CIJE-STEM/cije-weather-station/data/anemometer_data-V_vs_RPM.jpg

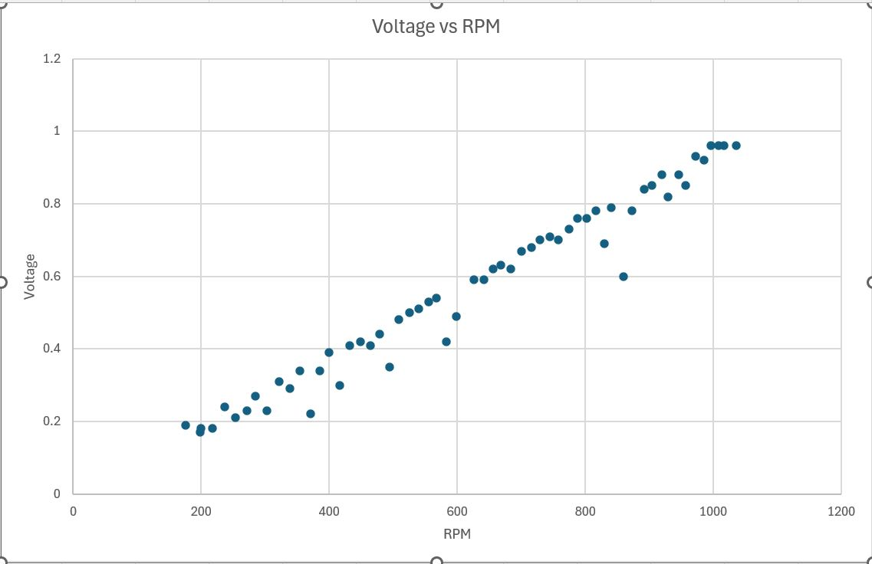
data/anemometer_data-V_vs_RPM.jpg
