CIJE-STEM/cije-weather-station/docs/ESP32-layout.png

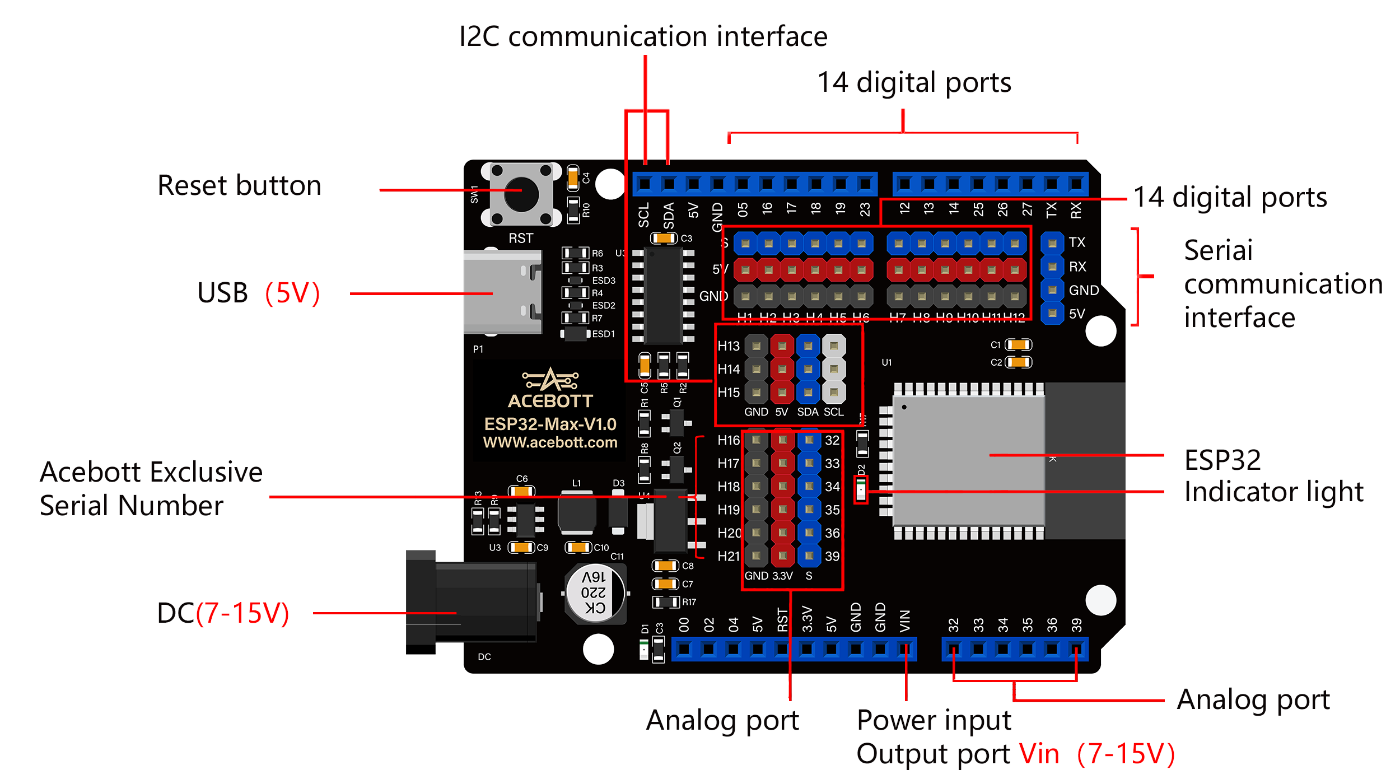
docs/ESP32-layout.png
