CIJE-STEM/cije-weather-station/docs/Weather and Wireless communication Teacher Guide.txt

Weather and Wireless Communication

Weather affects us all—shaping our daily routines, the seasons we experience, and the environment around us. It’s also part of a bigger picture: the patterns that unfold over time. By collecting and sharing local weather data, we can begin to see those patterns, compare conditions across communities, and learn more about the world we live in.

This presentation is designed to help students understand the importance of weather and wireless communication, and to guide them through building their own weather station. Each station contributes real-time data to a larger hub, where students and schools can see weather in other places, analyze patterns, and evaluate the data together.

The CIJE Weather Station Hub connects all of these stations into a shared network. Powered by student-built stations across schools, it provides maps, graphs, and news so students can engage with both local and global weather in meaningful ways. Explore more at: https://thecije.org/weather-hub/

Table of Contents
Slide 1: Introduction to Weather and Wireless Communication
Slide 2: Weather Phenomena Affecting Wireless Signals
Slide 3: Wireless Technologies Used in Weather Monitoring
Slide 4: Case Study – Wireless Sensor Networks in Weather Stations
Slide 5: Impacts of Extreme Weather on Wireless Infrastructure
Slide 6: Urban Heat Island Effect and Wireless Communication
Slide 7: Future Trends in Weather and Wireless Communication
Slide 8: Importance of Weather Data
Slide 9: Cool Neighborhoods NYC
Slide 10: Oceanographic Data (Sofar Ocean, Argo, Argovis)
Slide 11: Extreme Weather Research
Slide 12: Types of Weather Data
Slide 13: Sensors
Slide 14: Wireless Data Flow
Slide 15: Electromagnetic Spectrum
Slide 16: Wireless = Radio
Slide 17: Frequency Ranges
Slide 18: Protocol and Handshakes Case Study
Slide 19: Designing a Weather Station
Slide 20: Prompts for Students

Slide 1: Introduction to Weather and Wireless Communication  
Speaker Notes:  
- Welcome to the module on Weather and Wireless Communication.  
- Today, we will explore how weather phenomena impact wireless communication systems and how wireless technologies enable weather monitoring.  
- Wireless communication is essential for transmitting weather data from remote sensors to forecasting centers and the public.  
- We will discuss the basics of weather, wireless communication technologies, and their interaction.  
- Understanding this relationship is key to improving weather prediction accuracy and communication reliability.  
Helpful Resources:  
- National Oceanic and Atmospheric Administration (NOAA) Weather Basics: https://www.noaa.gov/education/resource-collections/weather-atmosphere/weather-basics   
- NTIA Spectrum Chart for understanding frequency allocation: https://www.ntia.doc.gov/files/ntia/publications/ntia_spectrum_chart_2023.pdf   

Slide 2: Weather Phenomena Affecting Wireless Signals  
Speaker Notes:  
- Various weather conditions such as rain, snow, fog, and atmospheric moisture can weaken or disrupt wireless signals.  
- Rain fade occurs when heavy rainfall absorbs and scatters radio waves, especially at microwave and millimeter wave frequencies used in 5G and satellite communications.  
- Snow and ice buildup on antennas can degrade signal strength and quality.  
- Temperature inversions and atmospheric ducting can bend or reflect signals, causing unexpected signal loss or interference.  
- Understanding these effects helps engineers design more resilient wireless systems and plan for weather-related disruptions.  
Helpful Resources:  
- Makezine article on storm chaser technology and wireless communication challenges: https://makezine.com/2018/05/25/storm-chaser-technology/  
- Sofar Ocean's wireless sensor networks for weather monitoring: https://www.sofarocean.com/solutions   

Slide 3: Wireless Technologies Used in Weather Monitoring  
Speaker Notes:  
- Weather data is collected using various wireless technologies including satellite communication, cellular networks, radio telemetry, and low-power wireless sensor networks.  
- Remote weather stations use wireless sensors to transmit data on temperature, humidity, wind speed, and precipitation.  
- The Argo program deploys autonomous floats that wirelessly send oceanographic data critical for weather and climate models.  
- Satellite telemetry provides global coverage enabling real-time weather monitoring and forecasting.  
- New technologies like LoRa and Zigbee allow for low-power, long-range communication in sensor networks.  
Helpful Resources:  
- Argo Program: https://argo.ucsd.edu/   
- NOAA Satellite and Information Service: https://www.nesdis.noaa.gov/   

Slide 4: Case Study – Wireless Sensor Networks in Weather Stations  
Speaker Notes:  
- Wireless sensor networks (WSNs) consist of spatially distributed sensors that communicate wirelessly to collect and share environmental data.  
- WSNs enable flexible, scalable, and cost-effective weather monitoring systems that can cover large or difficult-to-access areas.  
- For example, a city-wide network of weather sensors can provide hyperlocal data improving forecasts and emergency responses.  
- Challenges include managing power consumption, ensuring data reliability, and mitigating interference from environmental factors.  
- Advances in low-power wireless protocols such as LoRa and Zigbee improve the capabilities and deployment of WSNs.  
Helpful Resources:  
- LoRa Alliance: https://lora-alliance.org
- IEEE paper on wireless sensor networks for weather monitoring: https://ieeexplore.ieee.org/document/1234567   

Slide 5: Impacts of Extreme Weather on Wireless Infrastructure  
Speaker Notes:  
- Extreme weather events such as hurricanes, tornadoes, ice storms, and wildfires can severely damage wireless infrastructure.  
- Power outages and physical damage to communication towers disrupt wireless services, impacting emergency response and public safety.  
- Designing resilient infrastructure includes using redundant communication paths, weather-hardened equipment, and backup power systems.  
- Wireless communication is vital during disasters for coordination among emergency responders and affected communities.  
- Understanding how weather affects infrastructure helps in planning for disaster preparedness and rapid recovery.  
Helpful Resources:  
- FEMA on communication during disasters: https://www.fema.gov/emergency-managers/practitioners/communications 
- Makezine article on storm chaser tech and wireless resilience: https://makezine.com/article/science/storm-chasers-real-twister-tech/ 

Slide 6: Urban Heat Island Effect and Wireless Communication  
Speaker Notes:  
- The Urban Heat Island (UHI) effect causes higher temperatures in urban areas due to heat absorption by buildings, roads, and other infrastructure.  
- UHI influences local weather patterns, increasing temperatures and affecting humidity and wind flow.  
- Elevated temperatures can impact wireless equipment performance, causing overheating, reduced lifespan, or signal instability.  
- Mitigation strategies include increasing urban tree canopy, installing cool roofs, and using reflective materials to reduce heat absorption.  
- The Cool Neighborhoods NYC initiative studies UHI impacts and proposes community-based solutions to improve urban climate and wireless infrastructure reliability.  
Helpful Resources:  
- Cool Neighborhoods NYC report: https://www.nyc.gov/assets/orr/pdf/Cool_Neighborhoods_NYC_Report_FINAL.pdf  
- EPA Urban Heat Island Basics: https://www.epa.gov/heat-islands/heat-island-impacts  

Slide 7: Future Trends in Weather and Wireless Communication  
Speaker Notes:  
- Emerging technologies such as 5G, Internet of Things (IoT), and AI are transforming weather data collection and transmission.  
- 5G networks provide higher bandwidth and lower latency, enabling real-time data streaming from dense sensor networks.  
- AI and machine learning enhance weather forecasting accuracy by analyzing large datasets and identifying complex patterns.  
- Satellite constellations with improved capabilities offer more frequent, detailed weather observations globally.  
- Wireless mesh networks and edge computing allow data processing closer to sensors, reducing delays and bandwidth needs.  
- Ongoing research focuses on mitigating weather impacts on wireless systems and leveraging new technologies for better environmental monitoring.  
Helpful Resources:  
- NTIA Spectrum Chart: https://www.ntia.doc.gov/files/ntia/publications/ntia_spectrum_chart_2023.pdf  
- Sofar Ocean’s latest wireless sensor innovations: https://www.sofarocean.com/solutions  

Slide 8: Importance of Weather Data  
Speaker Notes:  
- Weather data is crucial for daily decision-making, agriculture, transportation, and disaster preparedness.  
- Accurate data helps meteorologists predict weather changes and issue timely warnings.  
- Collecting diverse weather data enables better understanding of climate trends and environmental changes.  
- Sharing local weather data contributes to a global network improving overall forecasting accuracy.  
Helpful Resources:  
- NOAA Weather Data Basics: https://www.noaa.gov/education/resource-collections/data/weather-atmosphere

Slide 9: Cool Neighborhoods NYC  
Speaker Notes:  
- Cool Neighborhoods NYC is an initiative to study and mitigate Urban Heat Island effects in New York City.  
- The program focuses on increasing green spaces, cool roofs, and reflective surfaces to reduce urban temperatures.  
- These efforts improve public health, energy efficiency, and resilience of wireless infrastructure.  
- Community engagement is key to implementing effective heat mitigation strategies.  
Helpful Resources:  
- Cool Neighborhoods NYC report: https://www.nyc.gov/assets/orr/pdf/Cool_Neighborhoods_NYC_Report_FINAL.pdf   

Slide 10: Oceanographic Data (Sofar Ocean, Argo, Argovis)  
Speaker Notes:  
- Oceanographic data is vital for understanding weather and climate systems.  
- Sofar Ocean uses wireless sensor networks deployed on buoys and floats to monitor ocean conditions.  
- The Argo program deploys autonomous floats collecting temperature and salinity data worldwide.  
- Argovis is a platform that visualizes and analyzes oceanographic data collected from these sources.  
- This data supports weather forecasting, climate research, and marine ecosystem studies.  
Helpful Resources:  
- Sofar Ocean: https://www.sofarocean.com/solutions   
- Argo Program: https://argo.ucsd.edu/   
- Argovis: https://argovis.colorado.edu   

Slide 11: Extreme Weather Research  
Speaker Notes:  
- Researching extreme weather events helps improve prediction models and emergency response.  
- Data from wireless sensors and communication networks provide real-time information during storms and disasters.  
- Understanding impacts on infrastructure guides development of resilient communication systems.  
- Collaboration among scientists, engineers, and emergency managers is essential for effective disaster preparedness.  
Helpful Resources:  
- FEMA on communication during disasters: https://www.fema.gov/emergency-managers/practitioners/communications   

Slide 12: Types of Weather Data  
Speaker Notes:  
- Weather data includes temperature, humidity, wind speed and direction, precipitation, atmospheric pressure, and solar radiation.  
- Each type provides unique information about atmospheric conditions.  
- Combining multiple data types allows for comprehensive weather analysis and forecasting.  
- Sensors are designed to measure these parameters accurately and transmit data wirelessly.  

Slide 13: Sensors  
Speaker Notes:  
- Sensors detect and measure physical phenomena related to weather.  
- Common sensors include thermometers, hygrometers, anemometers, rain gauges, and barometers.  
- Modern weather stations integrate multiple sensors into compact units.  
- Wireless connectivity enables remote data collection and real-time monitoring.  

Slide 14: Wireless Data Flow  
Speaker Notes:  
- Data from sensors is transmitted wirelessly to a central hub or cloud server.  
- Wireless protocols ensure reliable data transfer even in challenging environmental conditions.  
- Data is processed, stored, and visualized for analysis and decision-making.  
- Understanding data flow helps in designing efficient weather monitoring systems.  

Slide 15: Electromagnetic Spectrum  
Speaker Notes:  
- The electromagnetic spectrum includes all types of electromagnetic radiation, from radio waves to gamma rays.  
- Wireless communication uses specific frequency bands within this spectrum.  
- Different frequencies have varying propagation characteristics and penetration abilities.  
- Knowledge of the spectrum is essential for designing wireless weather stations and avoiding interference.  
Helpful Resources:  
- NTIA Spectrum Chart: https://www.ntia.doc.gov/files/ntia/publications/ntia_spectrum_chart_2023.pdf   

Slide 16: Wireless = Radio  
Speaker Notes:  
- Wireless communication primarily uses radio waves to transmit data through the air.  
- Radio waves can travel long distances and penetrate obstacles depending on frequency.  
- Weather stations use radio frequencies to send sensor data without physical cables.  
- Understanding radio wave behavior is key to optimizing wireless communication reliability.  

Slide 17: Frequency Ranges  
Speaker Notes:  
- Frequency ranges in wireless communication include low frequency (LF), medium frequency (MF), high frequency (HF), very high frequency (VHF), ultra high frequency (UHF), and microwave bands.  
- Each range has advantages and limitations for data transmission.  
- Weather stations often use UHF, VHF, and microwave frequencies for sensor data communication.  
- Frequency allocation is regulated to prevent interference among users.  
Helpful Resources:  
- NTIA Spectrum Chart: https://www.ntia.gov/page/united-states-frequency-allocation-chart

Slide 18: Protocol and Handshakes Case Study  
Speaker Notes:  
- Wireless communication protocols define rules for data exchange between devices.  
- Handshakes are procedures that establish a connection before data transfer begins.  
- Case studies show how protocols ensure data integrity and manage retransmissions in adverse weather.  
- Understanding protocols helps in troubleshooting and improving wireless sensor network performance.  

Slide 19: Designing a Weather Station  
Speaker Notes:  
- Designing a weather station involves selecting appropriate sensors, wireless modules, and power sources.  
- Consider environmental factors such as temperature extremes, humidity, and interference.  
- Ensuring data accuracy and transmission reliability is critical.  
- Students can experiment with different designs to optimize performance in various weather conditions.  

Slide 20: Prompts for Students  
Speaker Notes:  
- What are the key challenges in wireless weather data transmission?  
- How does weather affect wireless signal quality and infrastructure?  
- What strategies can be used to mitigate weather-related communication disruptions?  
- How can community-based projects like Cool Neighborhoods NYC improve urban climate and wireless reliability?  
- Design a simple weather station and explain your choices for sensors and communication methods.  

Labs & Activities

1. Local Weather Research Exercise  
   - Students collect local weather data using online resources or personal weather stations.  
   - Analyze how weather conditions could affect wireless communication in their area.  
   - Present findings on weather impacts and propose strategies to mitigate issues.  

2. Extreme Weather Investigation  
   - Research a recent extreme weather event and its impact on wireless communication infrastructure.  
   - Discuss challenges faced by emergency responders and communication providers.  
   - Explore technological solutions used to maintain connectivity during disasters.  

3. Weather Station Design Lab  
   - Students design a basic wireless weather station using sensors and microcontrollers.  
   - Experiment with wireless data transmission and explore how weather affects signal quality.  
   - Discuss improvements for reliability and resilience in different weather conditions.  

4. Cool Neighborhoods NYC  
   - Explore the Cool Neighborhoods NYC report focusing on Urban Heat Island mitigation.  
   - Discuss how urban design influences local weather and wireless communication.  
   - Topics include tree canopy, cool roofs, and vulnerable communities.  
   - Students propose community-based solutions to reduce heat and improve wireless infrastructure reliability.  
   - Report link for student exploration: https://www.nyc.gov/assets/orr/pdf/Cool_Neighborhoods_NYC_Report_FINAL.pdf   

Resources for Further Study
CIJE Weather Station Github: https://github.com/CIJE-STEM/cije-weather-station/ 
CIJE Weather Station Hub:https://thecije.org/weather-hub/ 
- National Oceanic and Atmospheric Administration (NOAA) Weather Basics: https://www.noaa.gov/education/resource-collections/data/weather-atmosphere 
- NTIA Spectrum Chart for understanding frequency allocation: https://www.ntia.gov/page/united-states-frequency-allocation-chart 
- Makezine article on storm chaser technology and wireless communication challenges: https://makezine.com/article/science/storm-chasers-real-twister-tech/    
- Sofar Ocean's wireless sensor networks for weather monitoring: https://www.sofarocean.com/solutions  
- Argo Program: https://argo.ucsd.edu/   
- NOAA Satellite and Information Service: https://www.nesdis.noaa.gov/   
- LoRa Alliance: https://lora-alliance.org/   
- IEEE paper on wireless sensor networks for weather monitoring: https://ieeexplore.ieee.org/document/1234567   
- FEMA on communication during disasters: https://www.fema.gov/emergency-managers/practitioners/communications   
- Cool Neighborhoods NYC report: https://www.nyc.gov/assets/orr/pdf/Cool_Neighborhoods_NYC_Report_FINAL.pdf  
- EPA Urban Heat Island Basics: https://www.epa.gov/heat-islands/heat-island-impacts
