CIJE-STEM/cije-weather-station/docs/Weather Station Build BME280 Basic.pdf

Weather Station Build

This Weather Station is just an example of many possible builds using different materials. Depending on what sensors you choose to incorporate, this build is designed to collect up to 4 types of weather data: temperature, humidity, wind speed and (optionally) barometric pressure. Essentially, there are 4 major components that can be adapted to your design preference: Container (+fasteners), sensors, processor, and transmitter.

Components:

Container:
Purchased or Repurposed

Any container that is big enough to hold the components AND is waterproof (sun and rain). Take home food and soup containers.

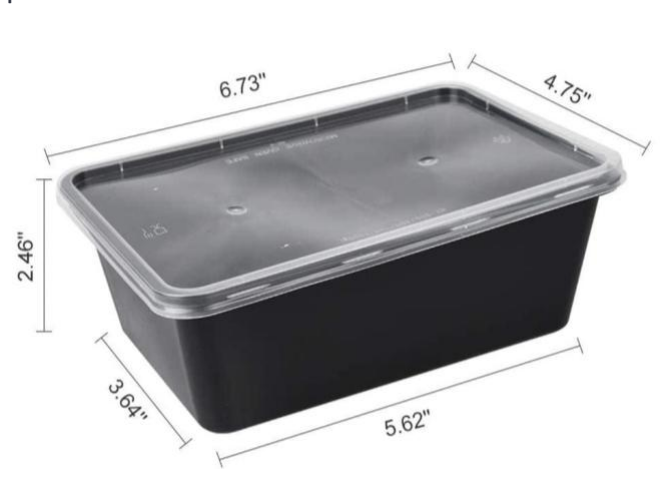
[picture p16: figure]

https://www.amazon.com/Containers-Disposable-Insulated-Microwaveable-Dishwasher/dp/B07BLTDD1V

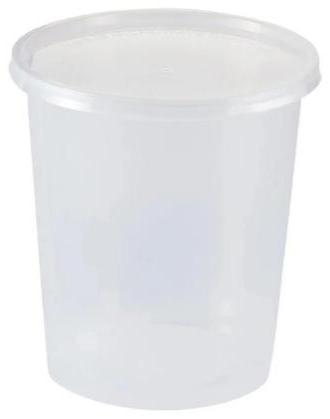
[picture p17: figure]
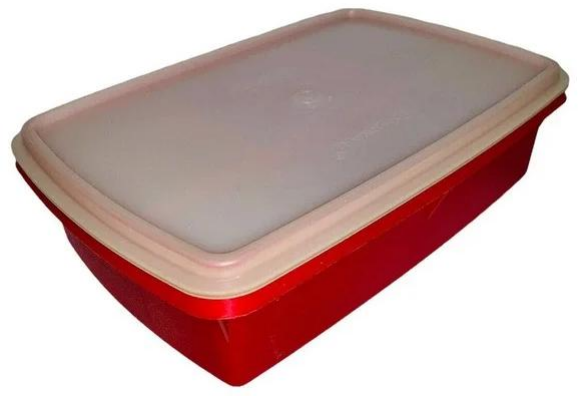
[picture p18: figure]

3D Printed Components.

You can design your own (or use our example seen below).

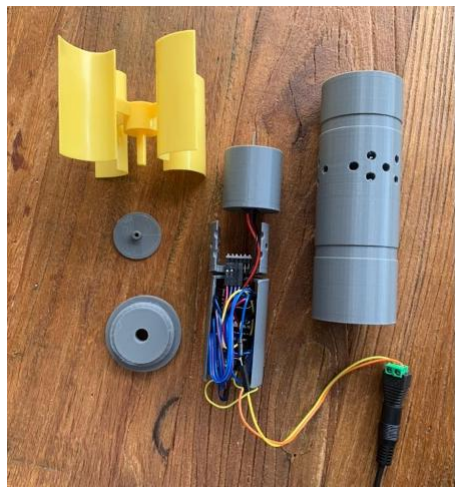
[picture p19: figure]

https://github.com/CIJE-STEM/CIJE-

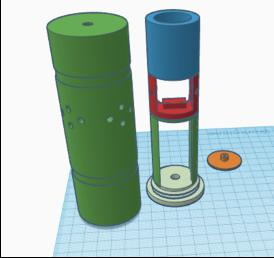
[picture p20: figure]

WeatherHub/tree/main/3D_files/CIJE_Weather_Station1 (https://github.com/CIJE-STEM/CIJE-WeatherHub/tree/main/3D_files/CIJE_Weather_Station1)

That can be adapted via Tinkercad.

https://www.tinkercad.com/things/kYxrZfITcn0-cije-weather-station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 (https://www.tinkercad.com/things/kYxrZfITcn0-cije-weather-station)

Fasteners:

The container needs to be anchored/attached to sometime stable to withstand wind and rain. Zip ties are the easiest to use.

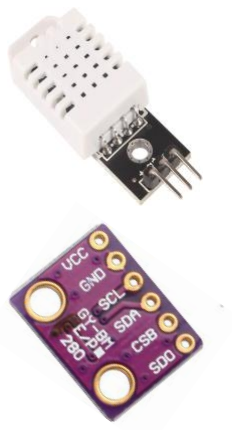
[picture p21: figure]

Sensors:

Temperature/Humidity sensor
- DHT22/DHT11 - I2C device measure temperature and humidity
- BME280 - I2C device measures temperature, humidity, and barometric pressure.

Wind Speed:

Anemometer - We are suggesting an anemometer adapted from a DC motor wind turbine. The voltage output will need to be calibrated to the wind speed.

https://www.amazon.com/Turbine-Vertical-Turbines-Electricity-Generator/dp/B0BWWVQZTG/ref=sr_1_16 (https://www.amazon.com/Turbine-Vertical-Turbines-Electricity-Generator/dp/B0BWWVQZTG/ref=sr_1_16)

Time: (optional)

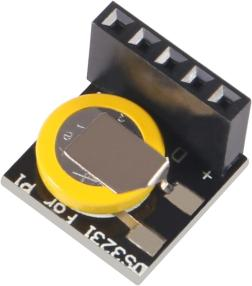
[picture p22: figure]

The DS3231 A real time clock (RTC) is great to have to

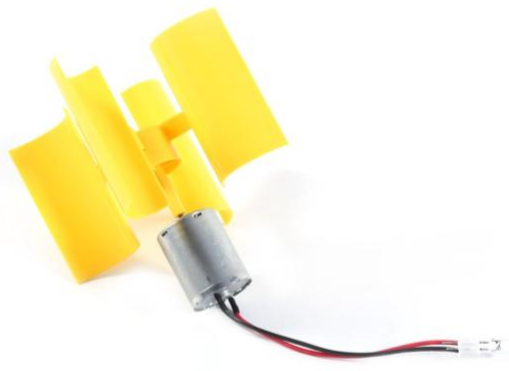
[picture p23: figure]

put the microprocessor to sleep and not use up the power (unless you manage to wire the power) when not in use / when not transmitting the data. There are other versions that are also available. This model has a rechargeable battery vs. a coin cell battery that will eventually need to be replaced.

https://www.amazon.com/Dorhea-DS3231-Module-Memory-

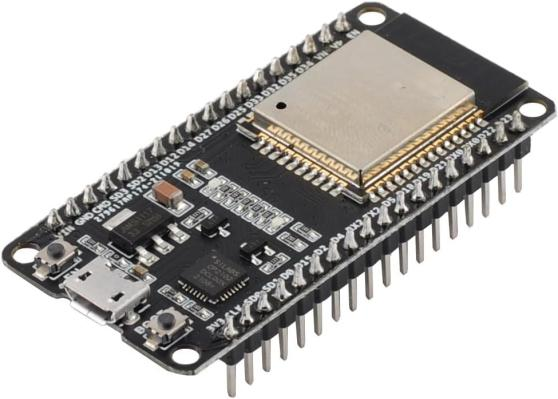
[picture p24: figure]
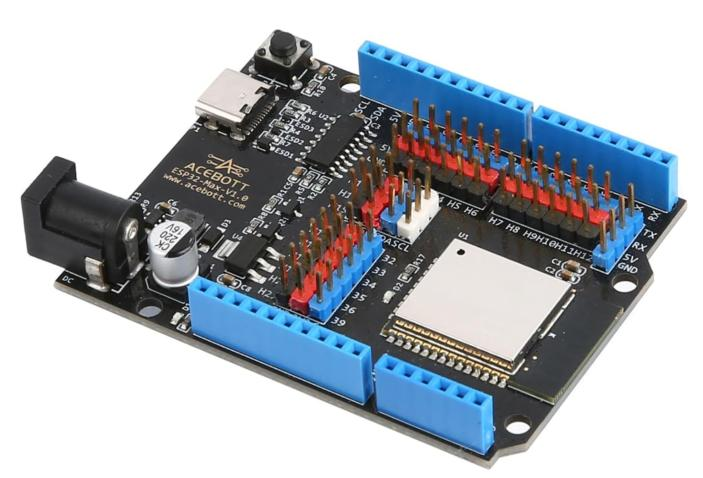
[picture p25: figure]

Raspberry/dp/B08X4H3NBR/ref=sr_1_3? (https://www.amazon.com/Dorhea-DS3231-Module-Memory-Raspberry/dp/B08X4H3NBR/ref=sr_1_3)

Processor/Transmitter

ESP32 (Processor AND transmitter}

Build-Up Options:

Your weather station can be built with a wide variety of options which will be explored. These options may be individual or combined depending on your needs.

Here are possible configurations:

Basic:
Internal sensors require minimal fabrication.
- Temperature, Humidity
- DHT-11, DHT22 Sensors.
- AHT10 Sensor.
- Temperature, Humidity, Pressure.
- BME280.
- Temperature, Humidity, Pressure, VOC’s (Volatile Organic Compounds - Air Quality)
- BME680.

Intermediate:
Sensors requiring some physical material fabrication, holes, mounting materials.
- (Basic Components - as listed above).
- Anemometer - DC Generator, resistors and a mounting bracket, hole for wiring.
- UV Sensor
- Adafruit LTR-390 - requires a hole and weather protective window.

Advanced:
Sensors that require moderate to extensive mechanical fabrication and adaptation, external holes.
- Wind Direction Sensor - rotary magnetic, optical, or mechanical switch sensing with an air vane to detect air flow direction.
- AS5600 - rotary magnetic position sensor.
- A3144 Hall Effect sensor or A3144 Hall Effect sensor module board, magnet(s).
- TCRT5000 Reflectance sensor(s), position disk.
- Participation Sensor (Rain Gauge)
- A3144 Hall Sensor, 3D printed tipping bucket assembly.
- LM393 Rain Drop Sensor Monitor.
- Capacitive Analog Soil Sensor Module.
- Rain gauge sensor with ultrasonic or TOF (Time of Flight) distance sensor.

The above options may be selected or combined to create your weather station. We will explore some of these options with design examples to help you get started.

First Steps:

- What is the intended application of your weather station?
- Classroom project, school project?
- Do you have an intended time frame for installation and use?
- Can you get permission and a designated place to install the weather station?
- Consider the location of your weather station.
- Is it to be inside or outside - Are measuring indoor air quality, lighting, etc.
- Does the location have readily available power?
- Does the location have readily available Wi-Fi?
- Is the location easily accessible?
- Is the location secure?
- What kind of data do you wish to collect?
- Some sensors are easy to use and require very little maintenance others may require occasional repair or adjustment.
- Are you considering microclimate measurement with multiple stations or having a relocatable station?
- How will you share the data with your students, school, community?
- Do you expect that your station and data will be used to help plan or make decisions based on the data you collect? For example, a community garden, air quality monitoring?
Based on the questions above hopefully you can formulate the intent and purpose of the weather station as well as what kind of data you wish to acquire/use.

Project Planning:

Consider the scope of your project and the resources that you will be able to apply. This project can be incremental, and scaled based on the resources that you have at hand. Consider a part of this project could be to build a case for expansion and permanence at your school, location. It may be useful to start small, demonstrate utility or interest and then expand.

Design Example - Basic - Web Based Reporting

In this example we want a weather station that can be located outside but next to a classroom window. We may find a better location later but for now we would like to have something that we can experiment with and easily observe. Power will be routed through the window using a 12V DC power adapter. Wi-Fi is available and reliable next to the window, and we have permission from our IT department to use the network. Our school is happy and interested in having the data posted on the CIJE Weather Station Hub site, so our IT department will allow outgoing internet traffic from our weather station.

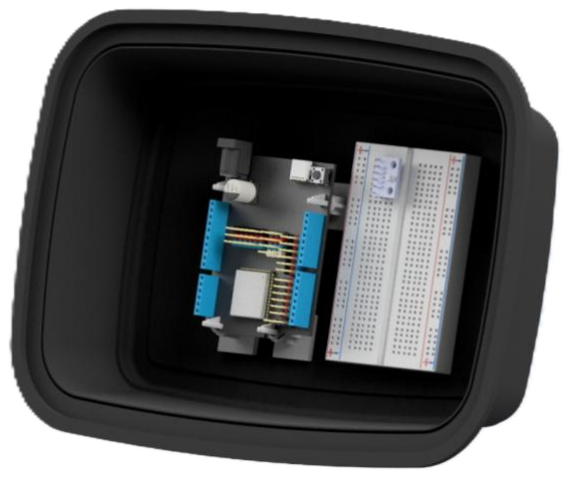
[picture p26: figure]

Shown above is an image of a basic weather station using an ESP32 (ACEBOTT), (https://www.amazon.com/ACEBOTT-Development-Board-Compatible-Arduino/dp/B0D5D7Q42V) a half bread board and a BME280 sensor. This is a very simple example of a web posting weather station.

We have some wiring to do, coding (most of it is provided) and some testing.

Weather Station Specifications:

# | Sensing Parameter | Sensor | Notes

1 | Temperature | BME280 - I2C - 3.3V-5V | Amazon - BM (https://www.amazon.com/SazkJere-GY-BME280-5-Atmospheric-Pressure-Temperature/dp/B0CMHGBPC7)E (https://www.amazon.com/SazkJere-GY-BME280-5-Atmospheric-Pressure-Temperature/dp/B0CMHGBPC7)280 not BM (https://www.amazon.com/SazkJere-GY-BME280-5-Atmospheric-Pressure-Temperature/dp/B0CMHGBPC7)P (https://www.amazon.com/SazkJere-GY-BME280-5-Atmospheric-Pressure-Temperature/dp/B0CMHGBPC7)280 (https://www.amazon.com/SazkJere-GY-BME280-5-Atmospheric-Pressure-Temperature/dp/B0CMHGBPC7)
| Humidity | BME280 - I2C - 3.3V-5V
| Pressure | BME280 - I2C - 3.3V-5V
# | Hardware | Type

2 | ESP32 | ESP32 Board | ACEBOTT UNO format ESP32 (https://www.amazon.com/ACEBOTT-Development-Board-Compatible-Arduino/dp/B0D5D7Q42V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)
3 | Breadboard | Mini Breadboard | Makes for easy design changes (https://www.amazon.com/Breadborad-Solderless-Breadboards-Distribution-Connecting/dp/B082VYXDF1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)
4 | 1N5817 Diode (2) | Overvoltage Protection | 1N5817 Schottky Diode (https://www.amazon.com/dp/B07Q5H1SLY?ref_=ppx_hzsearch_conn_dt_b_fed_asin_title_1)
5 | 10KΩ 1/4W Resistor | Anemometer V/Divider | 10K resistor

6 | 1KΩ 1/4W Resistor | Anemometer V/Divider | 1K resistor (https://www.amazon.com/10K-Resistor-Tolerance-Resistors-Resistance/dp/B0B4JFPHTW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)
7 | 100KΩ 1/4W Resistor | Battery V/Divider | 100K resistor (https://www.amazon.com/10K-Resistor-Tolerance-Resistors-Resistance/dp/B0B4JDHXC9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)
8 | 15KΩ 1/4W Resistor | Battery V/Divider | 15K resistor (https://www.amazon.com/10K-Resistor-Tolerance-Resistors-Resistance/dp/B0B4JCGX1Z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)
9 | 12VDC Adapter | 12V 1A 5.5mm x 2.1mm | Power for Station (https://www.amazon.com/Adapter-Speakers-Appliances-Surveillance-Switching/dp/B0CQXK1FSM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)
10 | Plastic Container | 48 oz, 7” x 10” x 2” | Station Enclosure (https://www.amazon.com/dp/B0CPP3KDQQ?ref_=ppx_hzsearch_conn_dt_b_fed_asin_title_1&th=1) - Zip-tied to block
11 | Snap-in Support | PCB Mounting Post | Amazon PCB Support (https://www.amazon.com/dp/B09WZWY9L3?aref=OMxKOacSRU)
12 | Dupont Jumpers | Female to Male (10) | Component interconnects (https://www.amazon.com/EDGELEC-Breadboard-Optional-Assorted-Multicolored/dp/B07GD2BWPY)
13 | Hot Glue | | To secure items if required

Network

SSID | URSchool
Password | 123456
IT Contact | Phone Number | email
Jim Dandy | 555-2134 | jd@ITOffice.biz

Note:
Resources listed are suggested components and vendors, you may use whatever source you see fit. It is recommended that component substitutes be selected based on similar specifications. Please consult your CIJE High School Mentor if in doubt prior to purchasing.

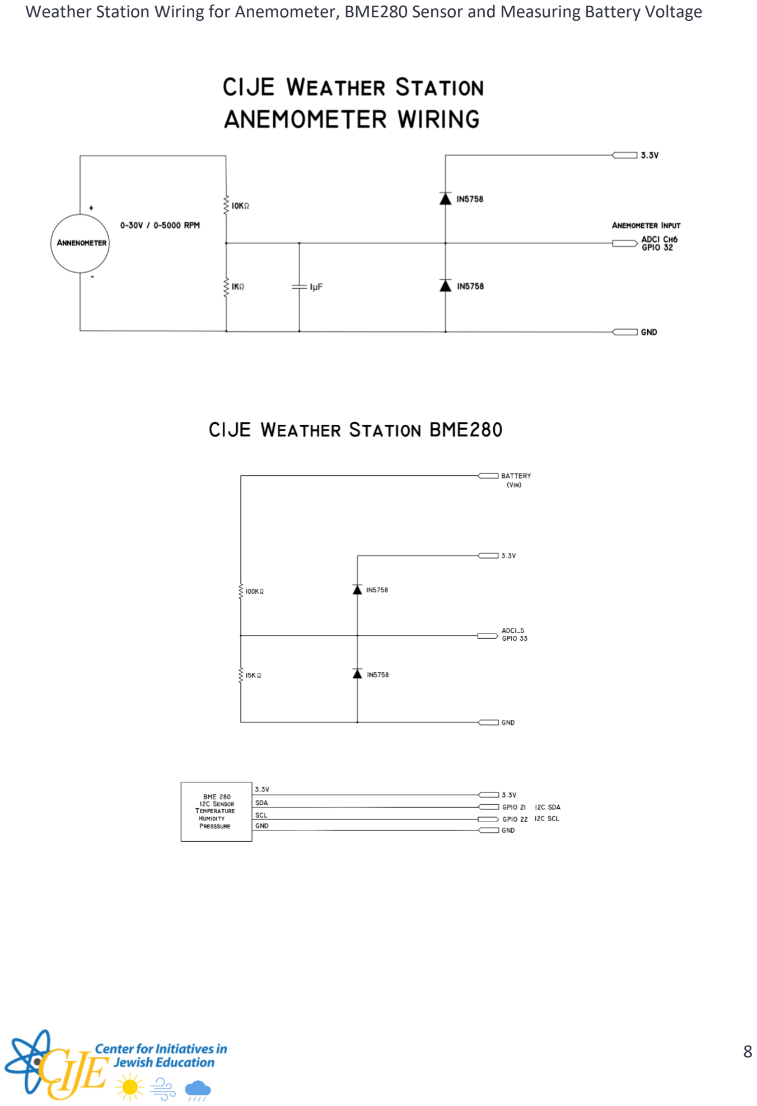
[picture p27: page 8]

Weather Station Wiring for Anemometer, BME280 Sensor and Measuring Battery Voltage

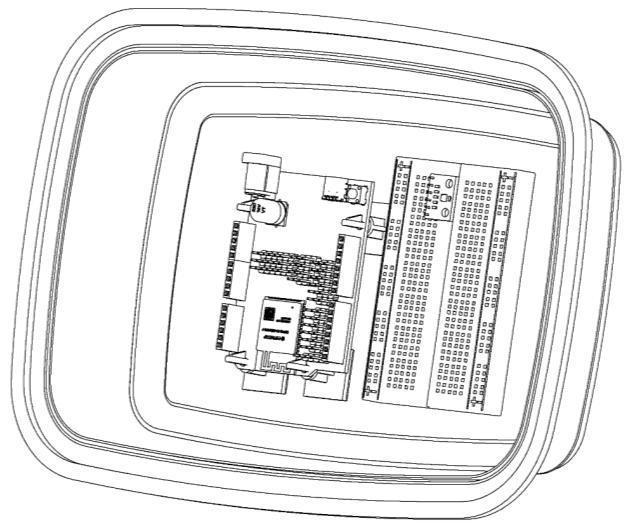
[picture p28: figure]

Food Tray Container 1
AceBott ESp32 | 1
Half Breadboard | 1
BME280 | 1
1N5817 Diode | 2
Snap-in Support | 3-4

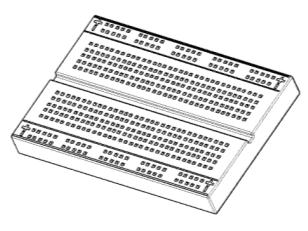
[picture p29: figure]

After gathering the above components, place them in the bottom of the Food Tray Container. Do a visual check first by placing them centered both vertically and horizontally next to each other. The easiest way to secure them is to use the adhesive Snap-in Support and the using the adhesive backing on the half breadboard. Mark or try positioning the ESP32 board and the half breadboard first and mark or identify where they go.

Steps:
- Insert the supports into the AceBott ESP32 board.
- Remove the adhesive, use the previous positioning and place it in the bottom, note it is suggested that once in place you apply hot glue to the adhesive pads to add another layer of attachment to the food tray.
- Remove the adhesive backing on the half breadboard and firmly place it next to the ESP32.
- You may insert the BME280 into the breadboard where you think it will work best.
- The BME280 pins VCC, GND, SDA, SCL should be accessible via other pins on the breadboard.
- You will connect pins via Dupont jumpers to the ESP32.

Now that you have mounted the components, make a couple of notes.

- The location of the programming port.
- The location of the power port.

Using the above information consider how you want to connect those ports to the outside. The programming port will only be used initially to program the weather station and may only be required for changes. Power will be required to operate the weather station and should be both secure (not easily removed) and weatherproof.
We have designed a weather seal that you can 3D print if you like. We have a cutout template as well. A small USB C port plug is also included. You will find the 3D
STL file and the cutout template in the weather station
resource drive.

After using the cutout and inserting the weather seal you may want to use Silicone RTV to attach the seal. RTV is a good adhesive to use, it is weatherproof, remains pliable and is easy to remove.
You can use the container lid as the base to mount and seal the
project. The weather station in its current configuration can be mounted in any orientation. However, if you plan on adding additional sensors it is recommended that the lid be mounted on the bottom and horizontal to the ground. You can secure the lid by any method that you prefer. We mounted the bottom using 4 holes and tie wraps.

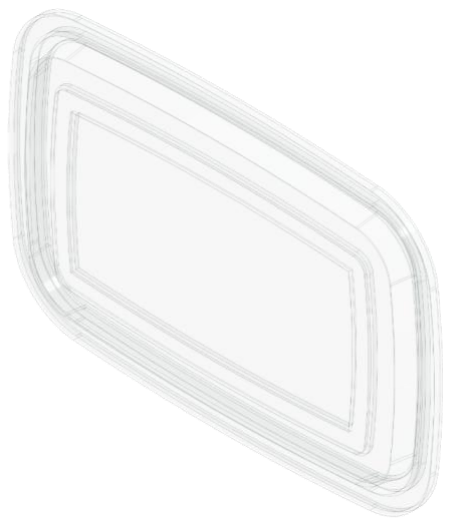
[picture p30: figure]

The bottom lid should have one or two small holes to allow for pressure equalization and moisture to exit. 1/16” holes are recommended. Larger holes may encourage insects to build nests in the enclosure and cause problems with the electronics.

Wiring:

Wiring the weather station will require minimal preparation.
- Acquire 4 Female to Male Dupont Jumpers.
- Using the following chart connect jumpers as shown in the wiring chart.

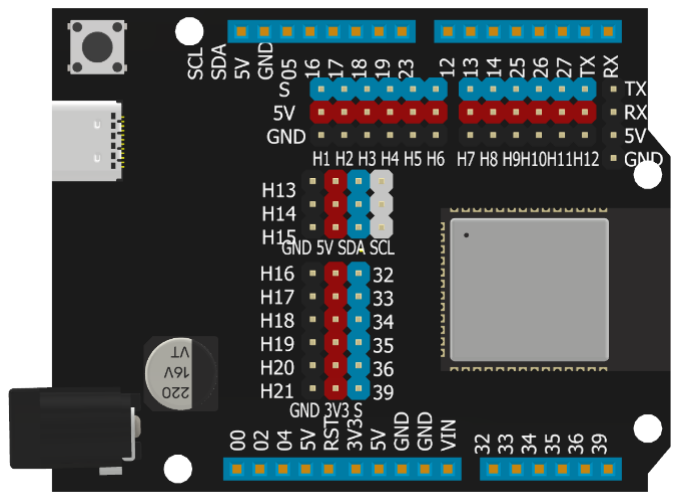
[picture p31: figure]
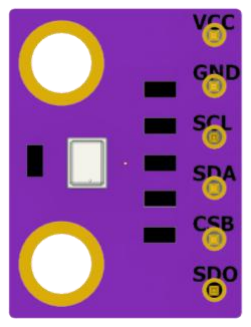
[picture p32: figure]

| Description | ESP32 | ESP32 Pin | Sensor | Sensor Pin
1 | BME280 Environmental Sensor | 5V | H15 5V | 5V | VCC
| | GND | H15 GND | GND | GND
| | SDA | H15 SDA | SDA | SDA
| | SCL | H15 SCL | SCL | SCL
2 | 100KΩ 1/4W Resistor | Receive the Battery voltage from the voltage divider network. Use pin 33 for the analog input. | | Form a voltage divider network, with one end of 100KΩ going to the battery supply, and the other to the junction of the 15KΩ. The other end of the 15KΩ should go to GND.
3 | 15KΩ 1/4W Resistor
4 | 1N5817 Diode (2) | Overvoltage Protection | 1N5817 Schottky Diode (https://www.amazon.com/dp/B07Q5H1SLY?ref_=ppx_hzsearch_conn_dt_b_fed_asin_title_1) | | 1N5817 Diode (2)

Upon completion have someone else double check the connections.
Note:
Resources listed are suggested components and vendors, you may use whatever source you see fit. It is recommended that component substitutes be selected based on similar specifications. Please consult your CIJE High School Mentor if in doubt prior to purchasing.

Software:

This may be the most challenging part of this project. If you have never used an ESP32 before there are a few steps that we have to take before we can use the ESP32 with the Arduino IDE.

Assuming you have used the Arduino IDE before we will need to open the application and set some parameters:

Open the Arduino IDE and using the File Tab, scroll down to the dialog box called “Preferences.”

Notice in the dialog box
the section a section that
says:
Additional Boards
manager URLs.

Click on the green window
selector on the right.

Here we will enter the URL that will point to
descriptions of the
Esprissif.

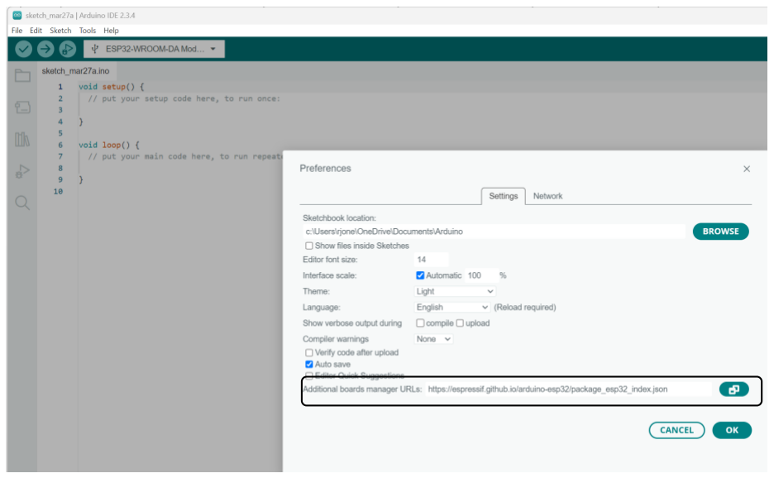
[picture p33: figure]

https://espressif.github.io/arduino-esp32/package_esp32_index.json

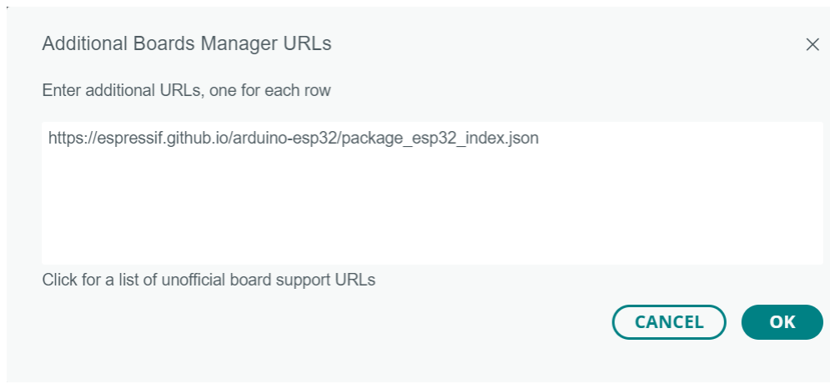
[picture p34: figure]

Cut and paste the above URL into the URL dialog box. When complete “Click OK”.

This will begin a process that will request the Arduino IDE to go out on the Internet to download the various board descriptions.

Note:
- You must have internet access to download these files.
- Depending on your Internet access it may take
up to a half hour or more to complete.
- You cannot proceed until this is accomplished.

Select the Board Manager to configure the IDE for ESP32 boards. On the Left Dialog tab, find and open the item marked as Board Manager (as shown on the right).

In the Boards Manager Search Box type “ESP32”. Typically, two suggestions will pop up.

- Arduino ESP32 Boards by Arduino
- esp32 by Espressif Systems

Install esp32 by Espressif Systems.
Installations will take a while so be patient.

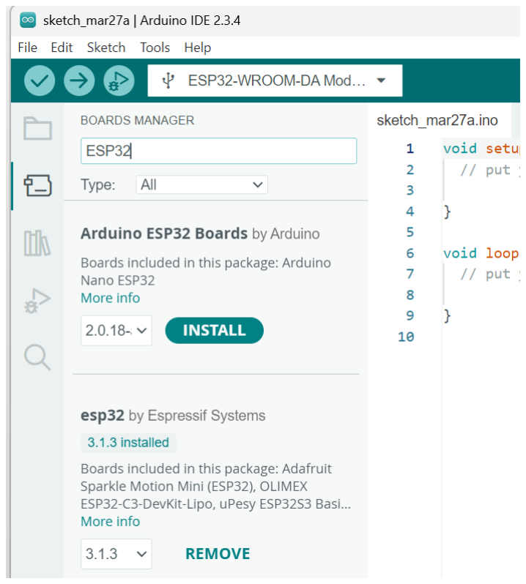
[picture p35: figure]

Upon completion of the Board Manager move to the “Tools” tab and scroll down to Board and allow the dialog box to open on the right. Select esp32 and allow that dialog box to open. You will see possibly 50 different boards and selecting the “right one” is critical to get your code to compile.

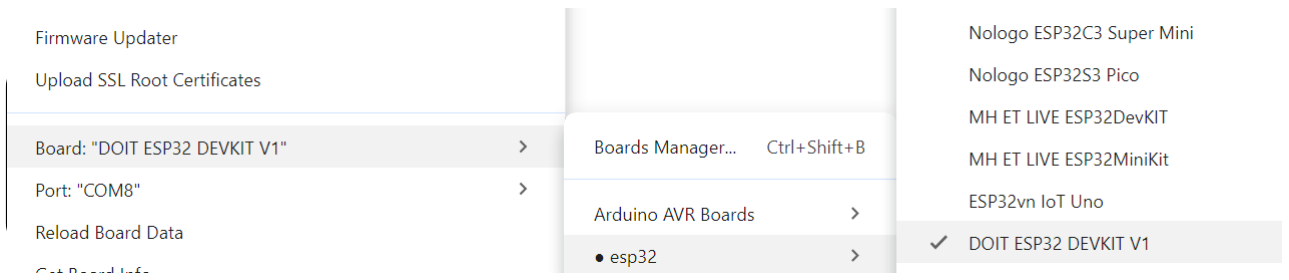
[picture p36: figure]

Scroll through the esp32 board tab and look for:
- DOIT ESP32 DEVKIT V1

This module will populate the various parameters of the board into the IDE. If you plug in the ACEBOTT board now you will have to select
the com port for programming.

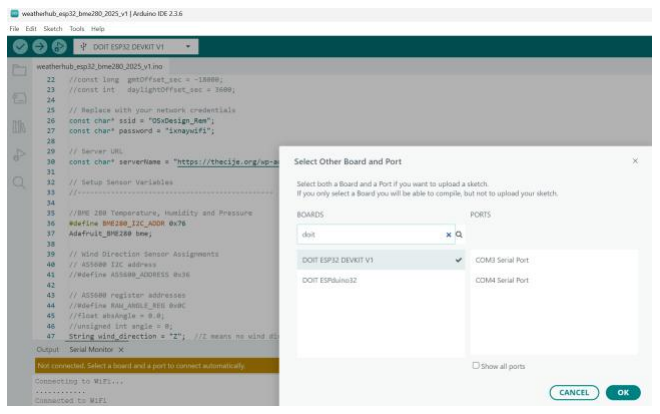
[picture p37: figure]

Select from the Tools Com Drop Down Box.

Note:
Resources listed are suggested components and vendors, you may use whatever source you see fit. It is
recommended that component substitutes be selected based on similar specifications. Please consult your CIJE High School Mentor if in doubt prior to purchasing.

The com port that the board is attached to.

In the example to the right
“COM8 Serial Port (USB)”
yours will probably be different.

Click “OK” when complete.

If you do not see an available COM port, please contact your instructor or IT specialist to identify the port location or Serial to USB driver for your PC (this process is different for PC’s, Mac’s and Chromebooks).

After completing these steps, we can begin configuring the IDE for the code, and sensors of your weather station.

For the basic weather station using the BME280 and the ACEBOTT ESP32 go to the following URL and download the following Arduino Program Code:

Code Operation:

Lines 25-27 are code inclusion statements for the various libraries need to:

- Enable Wi-Fi operation.
- Enable Web Server communication.
- Provide driver interface for BME280 Temperature,
Humidity and Pressure sensor.

Lines 62-76 setup variables to use with:
- CIJE Weather Station ID # and Passkey, obtained by registering your station on the CIJE Weather Station Site
- Require Network credentials, SSID and Password
- ULR location of the CIJE Weather station Server for data posting

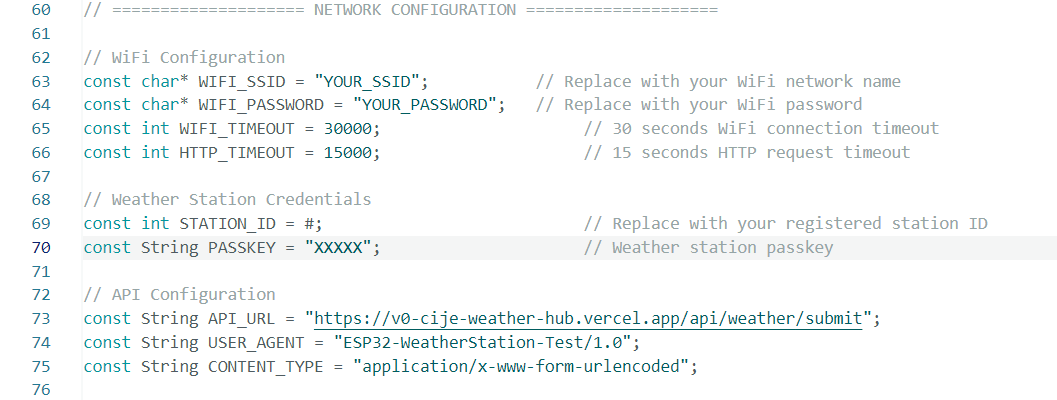
[picture p38: figure]

Lines 29-58 contain variable assignments and default variable values:
- BME-280 sensor instance assignment and I²C address
- Variables for
- Wind Speed
- Battery Voltage Sensor pin
- Battery Voltage A/D count
- Battery Voltage Analog value
- Wi-Fi Connection Wait Timeout value

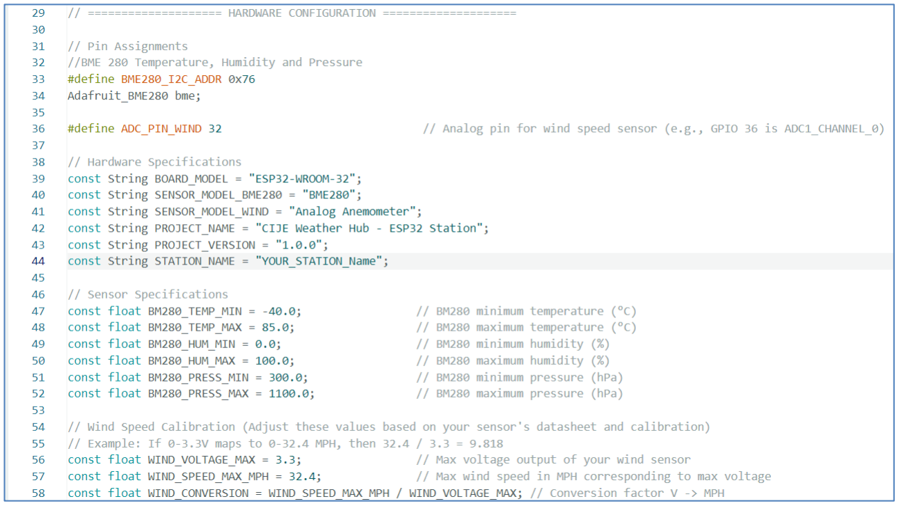
[picture p39: figure]

Lines 102-148 provide initialization instructions in void setup()
- Serial Monitor (115200 Baud)
- I

2C Initialization
- Find and verify BME-280 Sensor operation.
- Connect to Wi-Fi and verify operation
- Post Weather Data to CIJE Weather Station Web Portal

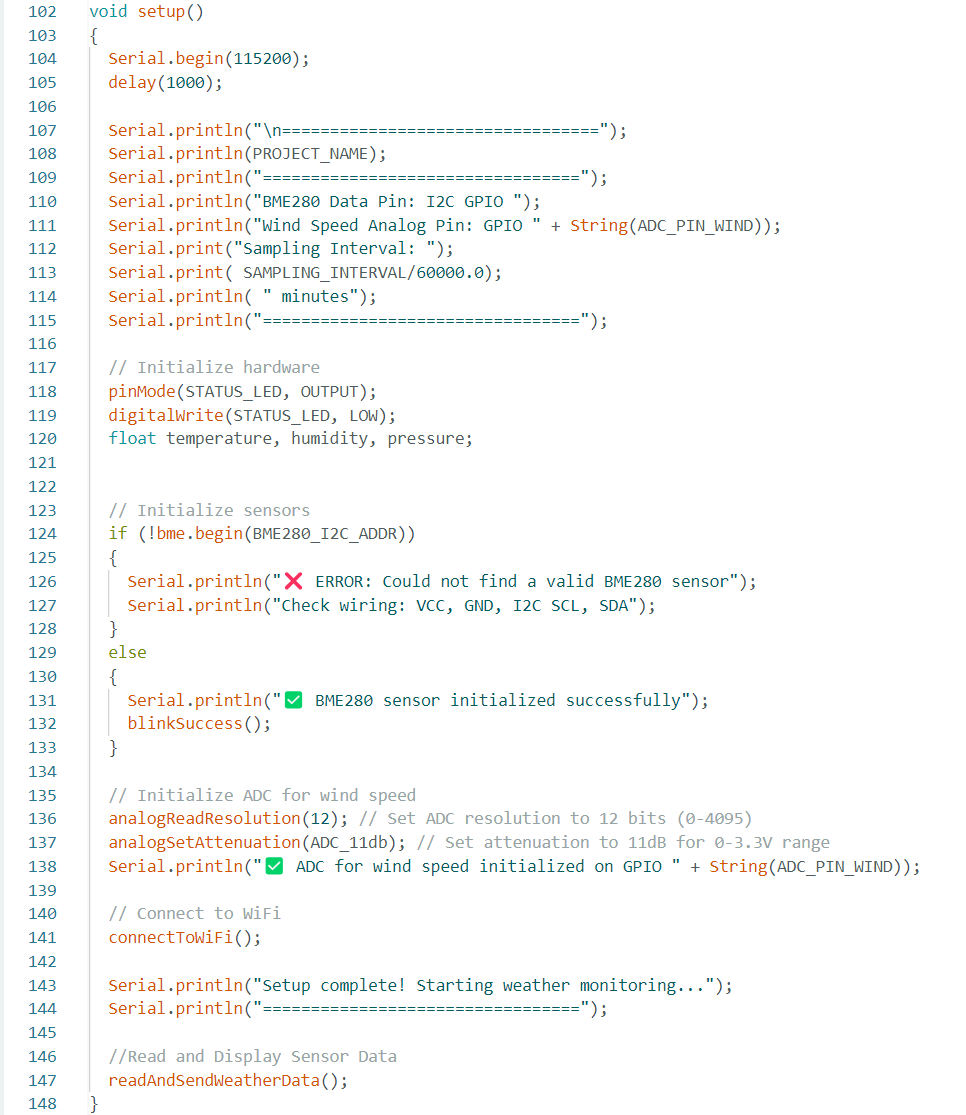
[picture p40: figure]

Lines 150-174 indicate null operation of the void loop().
- The primary function of the void loop() is to determine the post interval.
- Verify that the Wi-Fi connection is still active.
- LED Blink status light reporting.

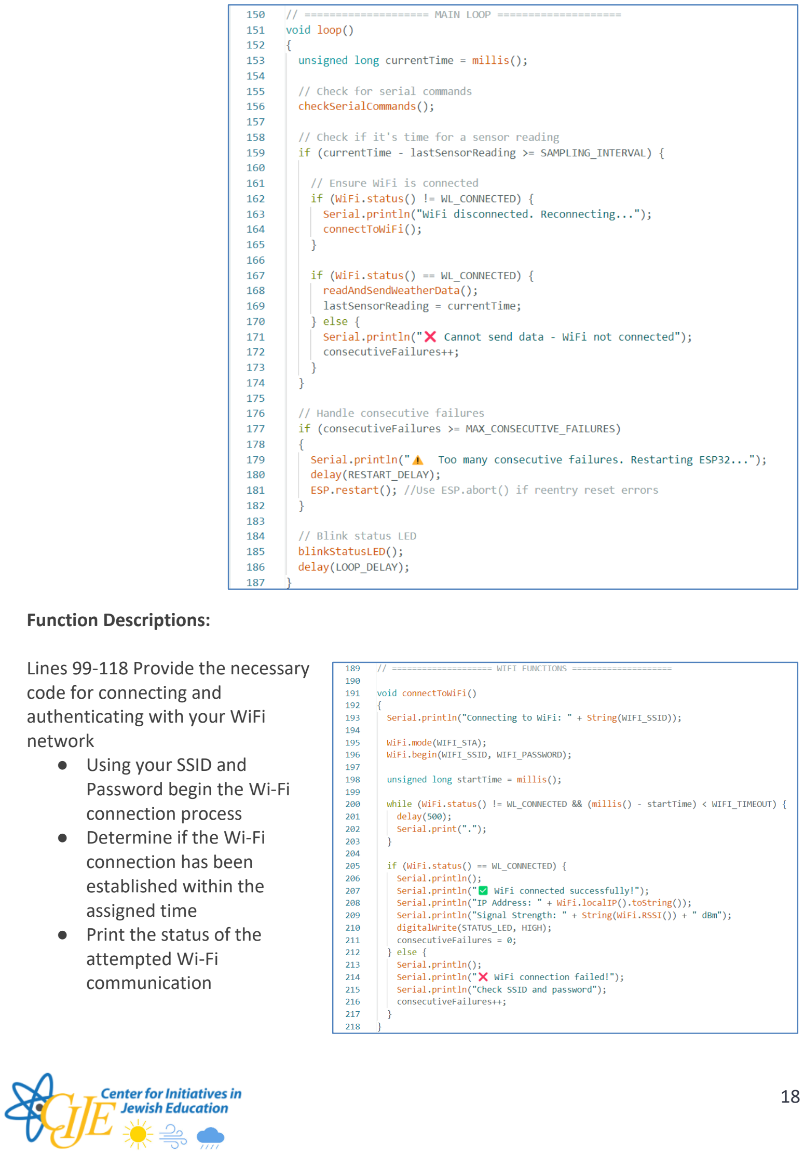
[picture p41: page 18]

Function Descriptions:

Lines 99

-118 Provide the necessary code for connecting and
authenticating with your WiFi network ● Using your SSID and

Password begin the Wi

-Fi
connection process
- Determine if the Wi

-Fi
connection has been
established within the
assigned time
- Print the status of the
attempted Wi

-Fi
communication

- Upon exit of the function return a “True” or “False” status of the attempt

Lines 222-231 is
used to read the
anaolog output of
the wind generator
and calculate the
wind speed.

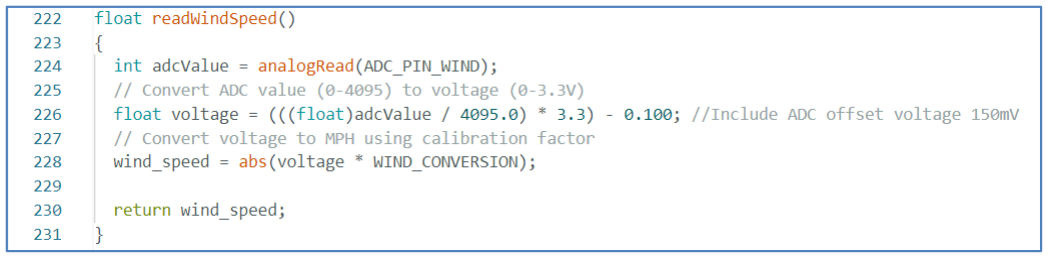
[picture p42: figure]

Note: This calculation may need to be adjusted for accurate readings.

Lines 233-260 Contains a set
of instructions to read the
weather sensors and to
format the data for sending (posting).
- Verify BME280 sensor
working
- Convert the BME280
sensor data into a
readable form
- Notify the Blink status
LED of sensor read.

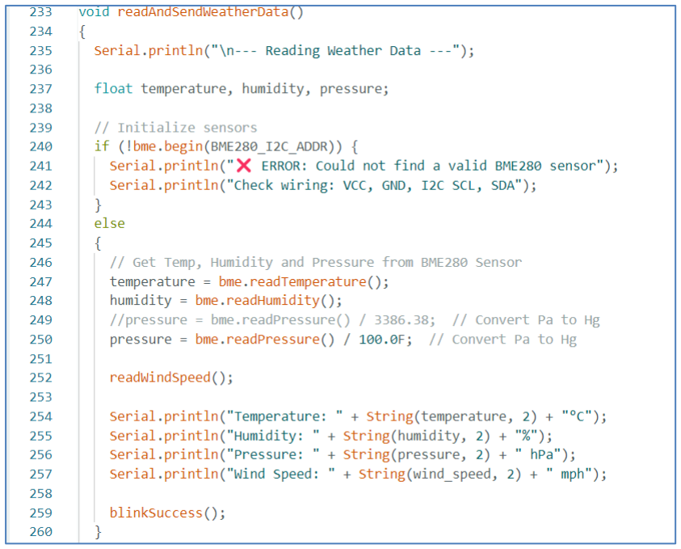
[picture p43: figure]

Lines 279-336 Contains a lengthy set of instructions to perform posting weather data to the CIJE Weather Station Portal.
Lines 280-284.
- Verify Wi-Fi is operational before Posting Data, if not post “Wi-Fi Disconnected”

Lines 286-290 Form the post header.

Lines 293-304 Collect and post the sensor data.

Lines 306-335 Verify and post diagnostic data regarding the data and posting process.

The previous code description outlines a basic Weather Station. Additional sensors and operations can be added to advance the capability of the Weather Station for Intermediate, and Advanced Operation.

Design Example - Basic - Local Reporting

In this example we want a weather station that can be located outside but next to a classroom window. We may find a better location later but for now we would like to have something that we can experiment with and easily observe. Power will be routed through the window using a 12V DC power adapter. We will use NRF2401 RF modules to wirelessly connect two (2) CIJE Arduino Uno’s together. Our goal is to display basic temperature and humidity data to an LCD Display in our classroom. We will add additional sensors later but will likely keep or upgrade the LCD display.

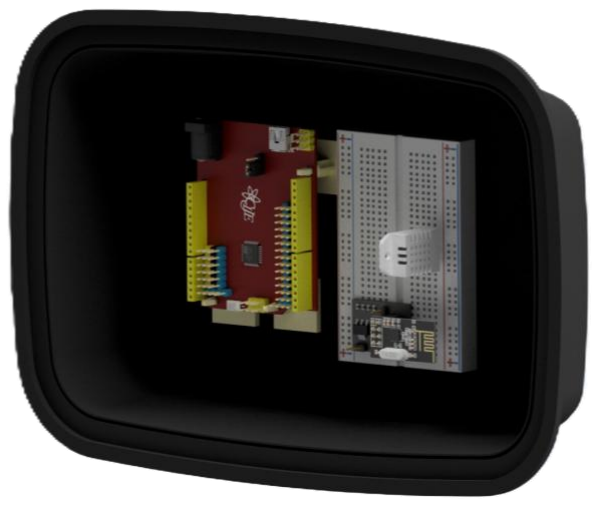
[picture p44: figure]
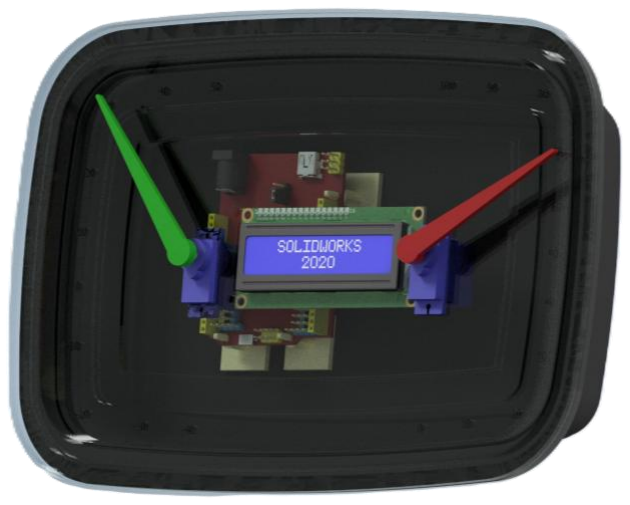
[picture p45: figure]

Shown above is an image of a basic weather station using an Arduino UNO (CIJE UNO), a half breadboard and a DHT-22 sensor. Local posting of data is done through another Arduino UNO (CIJE UNO) via an NRF2401 RF module. In this example numeric data is displayed on a 1602 I²C LCD with temperature and humidity also displayed through mini servos.

We have some wiring to do, coding (most of it is provided) and some testing.

UNO based Weather Station Transmitter

Weather Station Specifications:

# | Sensing Parameter | Sensor | Notes

1 | Temperature | DHT-22 3.3V-5V | Amazon - DHT-22 (https://www.amazon.com/Temperature-Humidity-Digital-3-3V-5V-Measure/dp/B0DSW53Q3C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)
2 | Humidity | DHT-22 3.3V-5V
# | Hardware | Type

1 | Arduino UNO | UNO | KeyeStudio (https://www.keyestudio.com/products/keyestudio-uno-r3-development-board-for-arduino-official-upgrated-version-with-pin-header-interface) or CIJE
2 | Breadboard | Mini Breadboard | Mount components for easy changes (https://www.amazon.com/Breadborad-Solderless-Breadboards-Distribution-Connecting/dp/B082VYXDF1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)
4 | 1N5817 Diode (2) | Overvoltage Protection | 1N5817 Schottky Diode (https://www.amazon.com/dp/B07Q5H1SLY?ref_=ppx_hzsearch_conn_dt_b_fed_asin_title_1)
4 | 12VDC Adapter | | Power for Station (https://www.amazon.com/Adapter-Speakers-Appliances-Surveillance-Switching/dp/B0CQXK1FSM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)
5 | Plastic Container | 48 oz, 7” x 10” x 2” | Station Enclosure (https://www.amazon.com/dp/B0CPP3KDQQ?ref_=ppx_hzsearch_conn_dt_b_fed_asin_title_1&th=1) - taped to block
6 | Snap-in Support | PCB Mounting Post | Amazon PCB Support (https://www.amazon.com/dp/B09WZWY9L3?aref=OMxKOacSRU)
7 | Dupont Jumpers | Female to Male (10) | Component interconnects (https://www.amazon.com/EDGELEC-Breadboard-Optional-Assorted-Multicolored/dp/B07GD2BWPY)
8 | Hot Glue
| Local Display
1 | Arduino UNO | UNO | Keyestudio (https://www.keyestudio.com/products/keyestudio-uno-r3-development-board-for-arduino-official-upgrated-version-with-pin-header-interface) or CIJE
2 | LCD 1602 | 16 Character x 2 Line I²C | Amazon (https://www.amazon.com/GeeekPi-Character-Backlight-Raspberry-Electrical/dp/B07S7PJYM6) or CIJE
3 | SG90 Micro Servo | 180° Micro Servo (2) | Amazon (https://www.amazon.com/Micro-Servos-Helicopter-Airplane-Controls/dp/B07MLR1498?sp_csd=d2lkZ2V0TmFtZT1zcF9hdGY) or CIJE
4 | 12V DC Adapter | 12V 1A 5.5mm x 2.1mm | Power for Station (https://www.amazon.com/Adapter-Speakers-Appliances-Surveillance-Switching/dp/B0CQXK1FSM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)
5 | Dupont Jumpers | Female to Male (10) | Component interconnects (https://www.amazon.com/EDGELEC-Breadboard-Optional-Assorted-Multicolored/dp/B07GD2BWPY)

6 | Plastic Container | 48 oz, 7” x 10” x 2” | Station Enclosure (https://www.amazon.com/dp/B0CPP3KDQQ?ref_=ppx_hzsearch_conn_dt_b_fed_asin_title_1&th=1) - Zip-tied to block

Note:
Resources listed are suggested components and vendors, you may use whatever source you see fit. It is recommended that component substitutes be selected based on similar specifications. Please consult your High School Mentor if in doubt prior to purchasing.

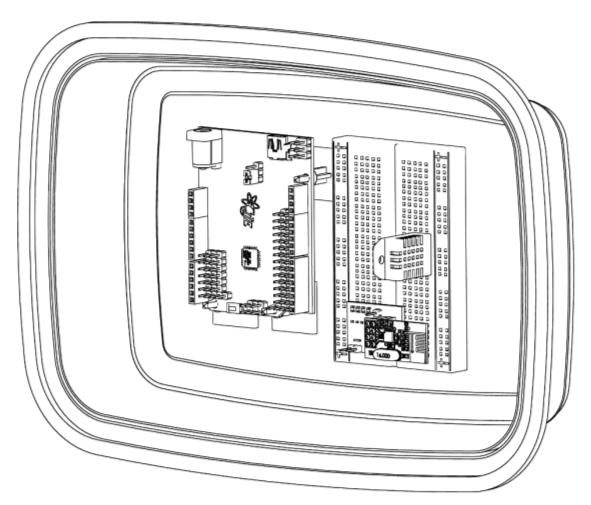
[picture p46: figure]

Food Tray Container 1
CIJE Arduino UNO | 1
Half Breadboard | 1
DHT-22 | 1
1N5817 Diode | 2
Snap-in Support | 3

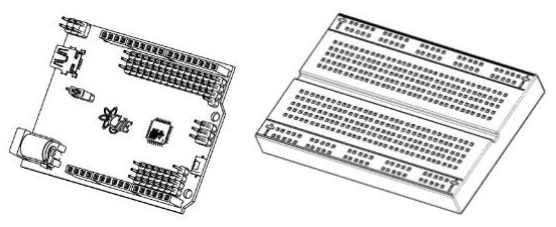
[picture p47: figure]

Food Tray Container 1
CIJE Arduino UNO | 1
1602 I²C LCD | 1
SG90 Micro Servo | 2
Snap-in Support | 3

Remote Transmitter Module

After gathering the above components, place them in the bottom of the Food Tray Container. Do a visual check first by placing them centered both vertically and horizontally next to each other. The easiest way to secure them is to use the adhesive Snap-in Support and the using the adhesive backing on the half breadboard. Mark or try positioning the Arduino UNO board and the half breadboard first and mark or identify where they go.

You may now secure the DHT22 sensor, NRF2401 RF module on the half-breadboard (use double sided tape for the RF module). On the half-breadboard place a 1KΩ and a 3.3KΩ resistor in series to form a voltage divider network. The top of the 3.3KΩ will go to your battery or power source. Where the 3.3KΩ and 1KΩ meet run a wire to the A0 analog input. Make sure the other end of the 1KΩ is grounded. This will form your voltage divider network to measure the power source (Vin).

Steps:
- Insert the supports into the UNO board, note it is suggested that once in place you apply hot glue to the adhesive pads to add another layer of attachment to the food tray
- Remove the adhesive, using the previous positioning and place it in the bottom.
- Remove the adhesive backing on the half breadboard and firmly place it next to the UNO board.
- You may insert the DHT-22 into the breadboard where you think it will work best.
- The DHT-22 pins VCC, GND, Signal (Data) should be accessible via other pins on the breadboard.
- You will connect pins via Dupont jumpers to the UNO.
- Place the two voltage divider resistors (3.3KΩ, 1KΩ) on the breadboard.
- Wire them accordingly to form a resistor
divider with the one end of the 3.3KΩ to be
attached to the battery positive terminal.
- At the junction of the 3.3KΩ and the 1KΩ run a Dupount jumper to the A0 analog input on the UNO.
- Make sure the other end of the 1KΩ goes to GND.
Now that you have mounted the components, make a couple of notes.
- The location of the programming port.
- The location of the power port.

Remote Receiver (Display Module)

After gathering the above components, place them in the bottom of the Food Tray Container. Do a visual check first by placing them centered both vertically and horizontally next to each other. The easiest way to secure them is to use the adhesive Snap-in Support and the using the adhesive backing on the half breadboard. Mark or try positioning the Arduino UNO board and NRF2401 RF Module first and mark or
identify where they go.

Using the clear cover center and mark the location of
the cuts for the LCD display and the two servos. We have included a paper cutout template for you to use as well. Carefully cut out the sections so that the LCD and the servos can be mounted to the clear cover. We have included a 3D printed bracket, and 3D dial pointers if you want to use them. The CNC cutout has the Temperature and Humidity Legend printed on it to help with assembly.

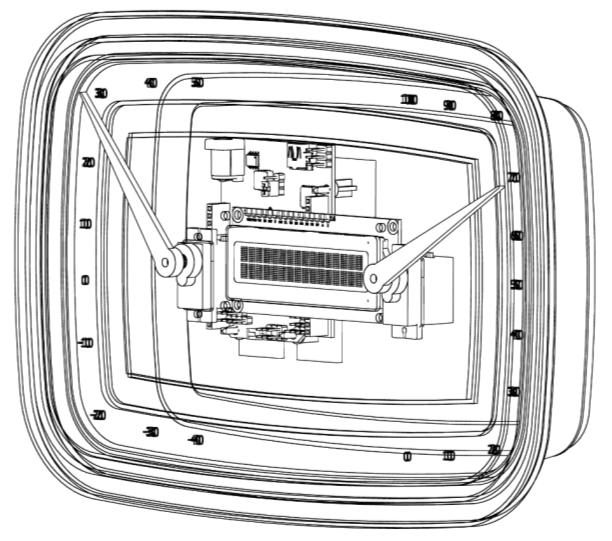
[picture p48: figure]

Shown below is the wiring table for both the weather transmitter and the receiver.

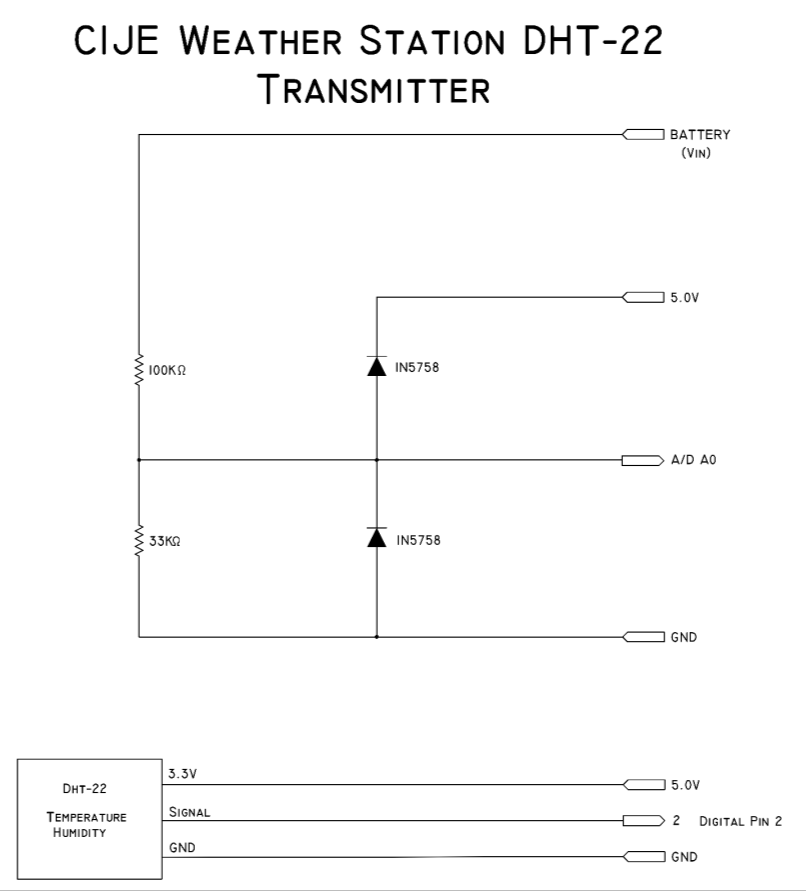
[picture p49: figure]

Weather Station Transmitter Wiring Table

| Description | UNO | UNO Pin | Sensor | Sensor Pin
1 | DHT-22 Temperature and Humidity Sensor | 5V | D2 5V | VCC | +
| | GND | D2 GND | GND | -
| | S | D2 S | Sensor Data | S

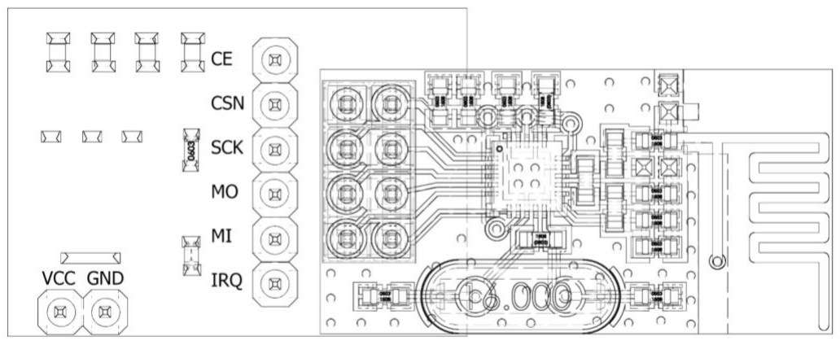
[picture p50: figure]

2 | NRF2401 RF Module Note: The NRF2401 requires a power adapter to operate with 5V systems. Top view of the power adapter and NRF2401 is shown above. | 5V | D13 VCC | VCC | 5V
| | GND | D13 GND | GND | GND
| | D9 | D9 S | CE | CE
| | D10 | D10 S | CSN | CSN
| | D11 | D11 S | MOSI | MO
| | D12 | D12 S | MISO | MI
| | D13 | D13 S | SCK | SCK

Upon completion have someone else double check the connections.

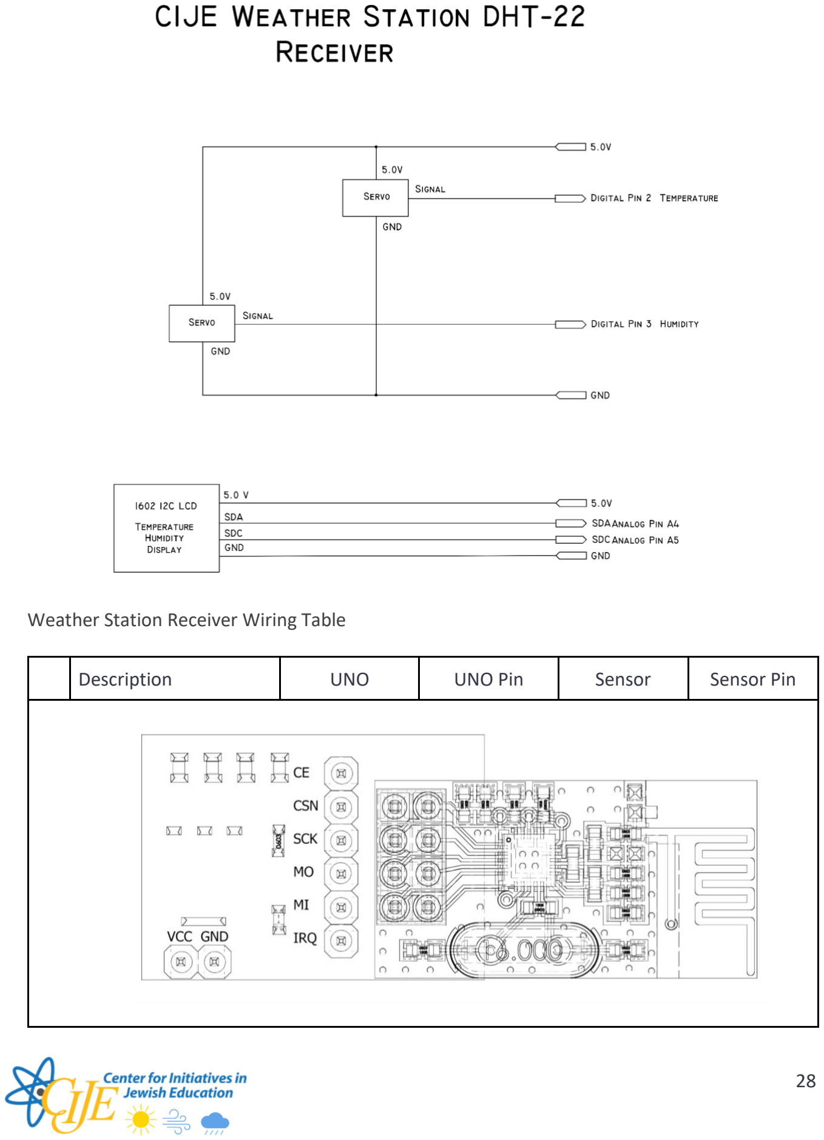
[picture p51: page 28]

Weather Station Receiver Wiring Table

Description | UNO | UNO Pin | Sensor | Sensor Pin

1 | NRF2401 RF Module Note: The NRF2401 requires a power adapter to operate with 5V systems. Top view of the power adapter and NRF2401 is shown above. | 5V | D13 VCC | VCC | 5V
| | GND | D13 GND | GND | GND
| | D9 | D9 S | CE | CE
| | D10 | D10 S | CSN | CSN
| | D11 | D11 S | MOSI | MO
| | D12 | D12 S | MISO | MI
| | D13 | D13 S | SCK | SCK

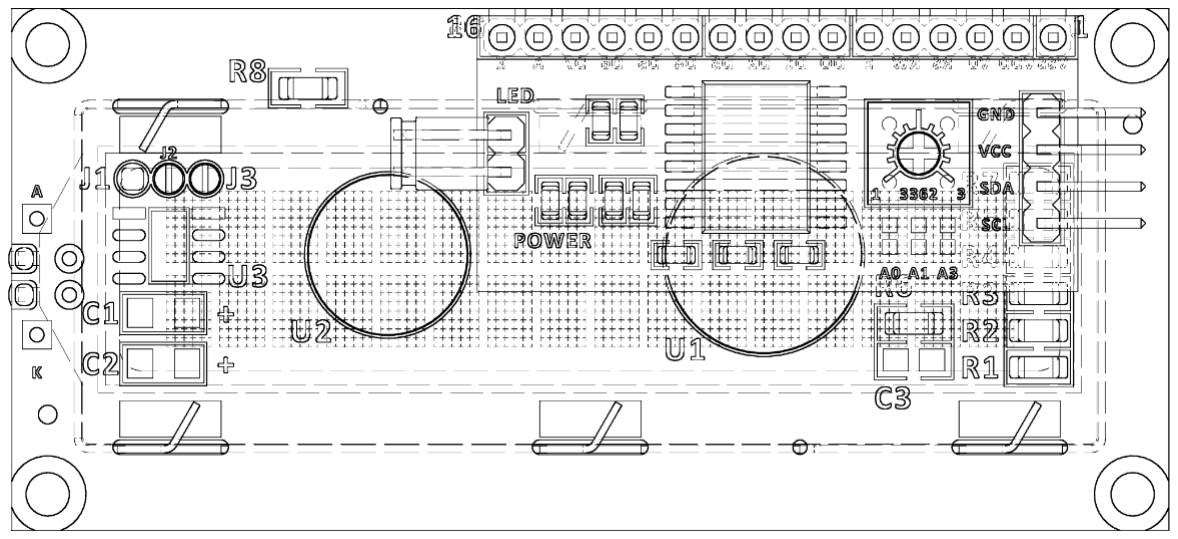
[picture p52: figure]

2 | 1602 I²C LCD | GND | I 2C GND | GND | GND
| | VCC | I 2C VCC | VCC | VCC
| | SDA | I 2C SDA | SDA | SDA
| | SCK | I 2C SCK | SCK | SCK
3 | Temperature Servo | D2 | D2 GND | GND | Brown
| | D2 | D2 VCC | VCC | Red

| | D2 | D2 S | Signal | Orange
4 | Humidity Servo | D3 | D3 GND | GND | Brown
| | D3 | D3 VCC | VCC | Red
| | D3 | D3 S | Signal | Orange

Upon completion have someone else double check the connections.

Operational Details

The Arduino UNO Transmitter is configured to sample data from the DH-22 to obtain temperature and humidity data. This is done periodically (about 1 second), during this sampling period the battery voltage is sampled through the A0 analog port through a resistor divider network.

The data is then placed in a C++ “Structure” in the code so that the NRF2401 transmit library can form packets for transmission. The NRF2401 library provides data transparency and packet recovery to ensure that the data set is delivered securely.

The Arduino UNO receiver is configured to use the NRF2401 receiver library to accept incoming data from the weather station transmitter. Data packets are received and placed in the C++ “Structure” for decoding. The data is decoded to provide inputs for the 2 line x 16 character LCD display and for two servos. Data decoded for the LCD display includes Temperature (°C), Humidity (%) and the Battery voltage (V) at the transmitter. The two servos are used to provide an analog indication of Temperature and Humidity. The servo library provides the control signals to the servo while the C++ “map” function is used to convert Temperature and Humidity data into meaningful position commands.

The location of the remote unit may require some trial and error. The NRF2401 operates on the same frequency band as WiFi and depending on your location may experience interference. If you find that the remote or local unit has intermittent connectivity try relocating the remote or local unit closer or in a different location.

Transmitter Code Description:

Lines 1-38 Contain various elements required to include and assign variables for the the Transmitter Module to operate Lines 1-3
- SPI (Serial Peripheral
Interface) Library
- NRF2401 RF module
minimal code library
(Lite)
- DHT-22 Temperature and
Humidity Sensor Library
Lines 6-38
- Create sensor instance
for the DHT-22 Sensor,
and assign the Sensor Pin
Number
- Create “static variables” for the operation of the
NRF2401 RF module
- Radio ID for TX,
this may need to
be reassigned in a
multiple

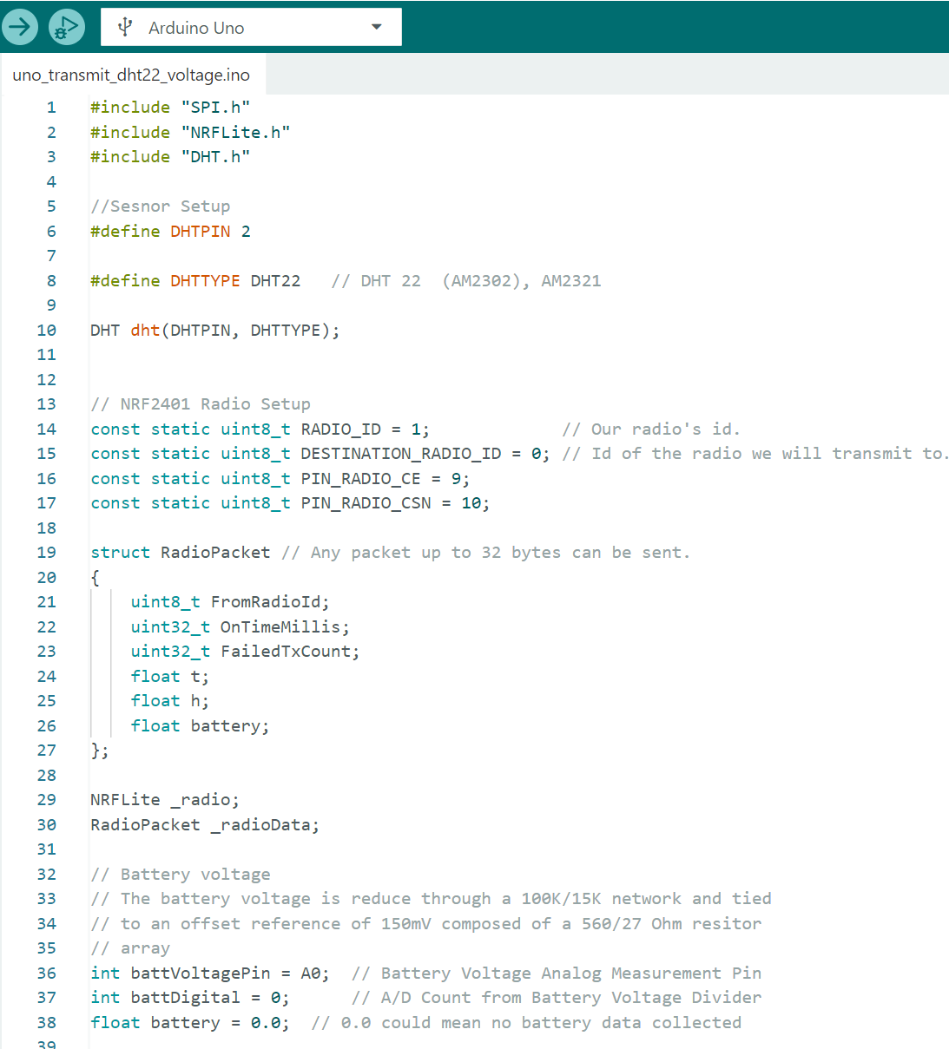
[picture p53: figure]

Transmitter, receive environment
- In a similar fashion the Destination Radio (receiver) may have to be reassigned to avoid interference with other radios
- Assign the hardware pin numbers for the CE (Chip Enable) and CSN (Chip Select Not) is used to enable various transmit and receive mode operations
- Create and assign a data “Structure” to hold and transfer data between the Transmitter the Receiver modules
- Create instances for the various NRF2401 Radio functions
- Declare the “Type” and default values for the battery voltage measurement

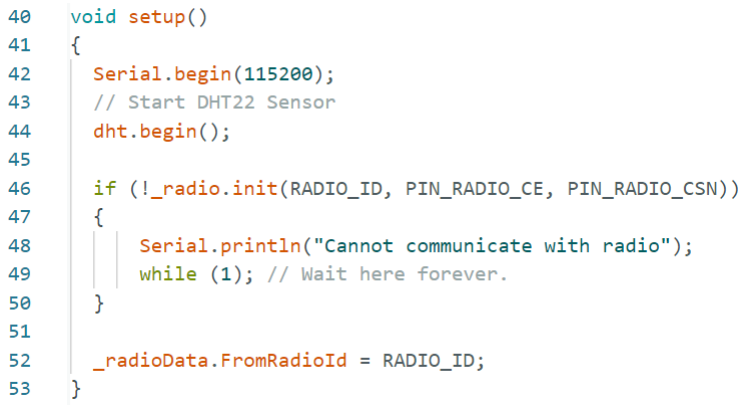
[picture p54: figure]

Lines 40-53 Using the void setup() function
initialize the Serial Monitor, the DHT-22 Sensor
and verify that the NRF2401 radio module is
operational
- Being the Serial Monitor
- Begin DHT-22 Operation
- Check for the NRF2401 Operation
- Assign the Local Radio ID value

Line 55-121 The void loop() functions performs the various functions of reading sensors, formatting and sending data through the NRF2401 RF Module
Lines 59-75 Gather Sensor Data
- Read the battery voltage from the A/D I/O port
- Convert and calculate the equivalent Analog Battery Voltage, an offset of 0.45 Volts is added to the measurement due to a diode that is present in the Vin line on the UNO
- Read and Assign the various temperature, humidity values from the DH-22 sensor. Not all are used or posted (these may be added at your discretion to your local weather station if desired)
Lines 77-100 Format data and report to the serial monitor the data values.
- Print to the Serial monitor the various sensor and battery voltage
readings
- Assign sensor data values to the

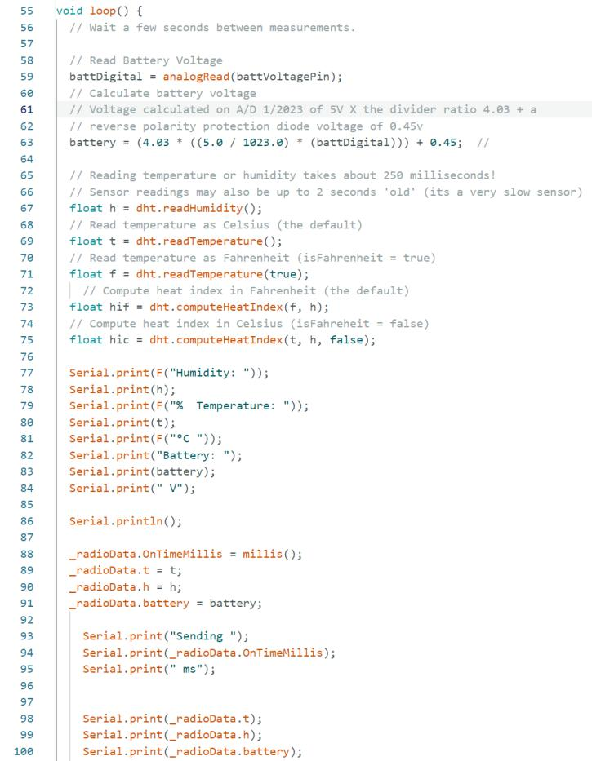
[picture p55: figure]

necessary structure variables for transmission
- Report on data transmission
- Print values to be sent via the NRF2401 Radio

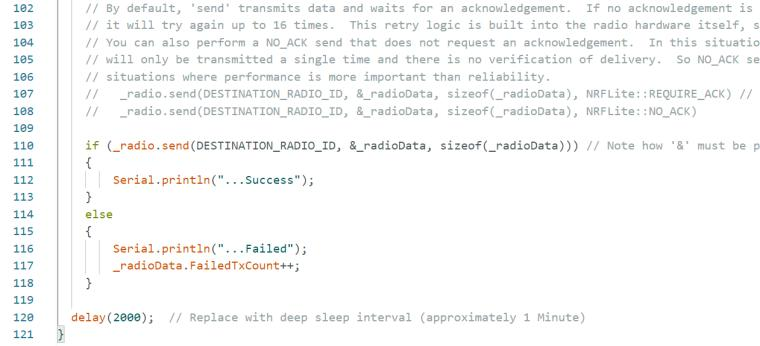
[picture p56: figure]

Line 102-121 Perform data
transmission and transmission status
- Check on transmission status
and report on success of
transmission
- Set the “rest interval”
between sensor data
gathering and data
transmission

Receiver Code Description:

Lines 1-50 Provide NRF2401 hookup instructions, interfacing with LCD and data structures for the received remote data.
Lines 6-14 Provide NRF2401 Radio Pin number assignments
Lines 17-21 Provide Library assignments for the various used in the Weather Station Receiver
- I

2C Library for the LCD
- The required library to
communicate with the
1602/2004 I²C LCD
- The required library for the SPI (Serial Peripheral Interface) of the NRF2401 RF module
- The Transmission/Reception Library of the NRF2401
- The Library for using Servos with
the UNO

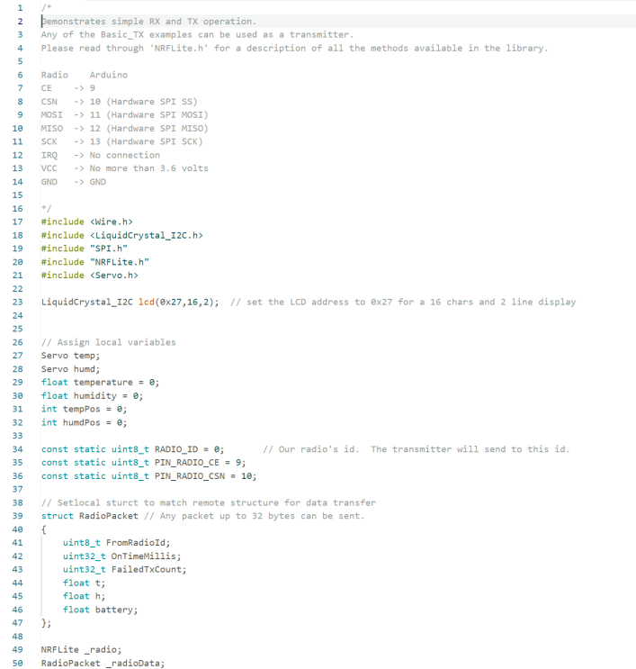
[picture p57: figure]

Lines 27-50 Provide the various variables use to store and present data received front the remote weather station transmitter
- Create an instance for the LCD, noting its address (0x27) and alternate address is 0x3F, and display format (16 character, 2 Lines)
- Various variable assignments for temperature, humidity and servo position values
- Variables required for use with the NRF2401 Radio module, note values for the Radio ID must match that of the Transmitter
- Assignment the necessary data structure for use with the NRF2401
- Create instances for the various NRF2401 Radio functions

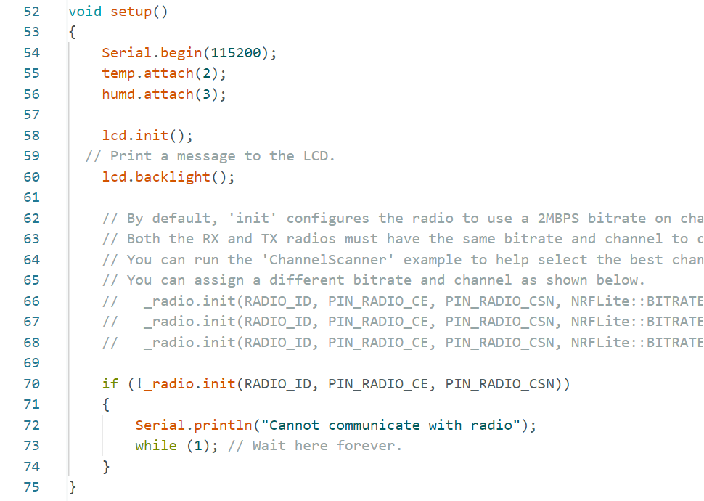
[picture p58: figure]

Lines 52-75 Using void setup() initialize various hardware elements used in the weather station receiver
- Initialize the Serial Monitor
- Connect the Temperature and Humidity display servos
- Initialize the LCD and turn on the backlight
- Verify that the NRF2401 radio is operational and report status

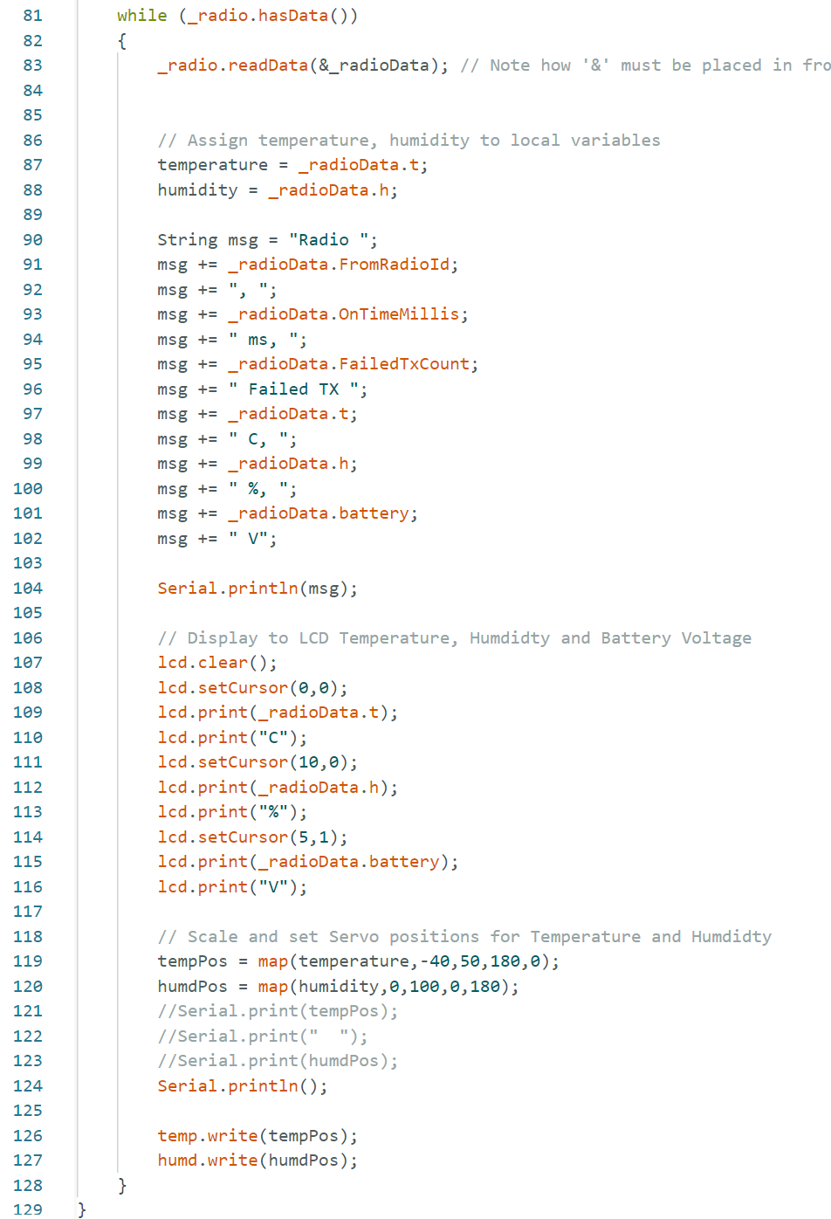
[picture p59: figure]

Lines 81-129 The void loop() is used to access the NRF2401 Radio Receiver Module and to display the remote data Line 81-104 Create an active receive loop for incoming data from the NRF2401
- Receive data from the remote and place data into the radio data structure
- Using received data create a message to display via the serial monitor
- Using the LCD display gather the received data format it for displaying on the LCD
- Using the received temperature and humidity data “map” the data values to the range of allowable servo values (0-180 degrees) Also note that displays are on the left and right. The left servo display will require inverting the data values for proper orientation
- Send the formatted data to the servos
