CIJE-STEM/cije-weather-station/docs/Weather Station Build DHT22 Basic.pdf

Weather Station Build

This Weather Station is just an example of many possible builds using different materials. Depending on what sensors you choose to incorporate, this build is designed to collect up to 4 types of weather data: temperature, humidity, wind speed and (optionally) barometric pressure. Essentially, there are 4 major components that can be adapted to your design preference: Container (+fasteners), sensors, processor, and transmitter.

Components:

Container:
Purchased or Repurposed

Any container that is big enough to hold the components AND is waterproof (sun and rain). Take home food and soup containers.


https://www.amazon.com/Containers-Disposable-Insulated-Microwaveable-Dishwasher/dp/B07BLTDD1V


3D Printed Components.

You can design your own (or use our example seen below).


https://github.com/CIJE-STEM/CIJE-


WeatherHub/tree/main/3D_files/CIJE_Weather_Station1 (https://github.com/CIJE-STEM/CIJE-WeatherHub/tree/main/3D_files/CIJE_Weather_Station1)

That can be adapted via Tinkercad.

https://www.tinkercad.com/things/kYxrZfITcn0-cije-weather-station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 (https://www.tinkercad.com/things/kYxrZfITcn0-cije-weather-station)

Fasteners:

The container needs to be anchored/attached to sometime stable to withstand wind and rain. Zip ties are the easiest to use.


Sensors:

Temperature/Humidity sensor
- DHT22/DHT11 - I2C device measure temperature and humidity
- BME280 - I2C device measures temperature, humidity, and barometric pressure.

Wind Speed:

Anemometer - We are suggesting an anemometer adapted from a DC motor wind turbine. The voltage output will need to be calibrated to the wind speed.

https://www.amazon.com/Turbine-Vertical-Turbines-Electricity-Generator/dp/B0BWWVQZTG/ref=sr_1_16 (https://www.amazon.com/Turbine-Vertical-Turbines-Electricity-Generator/dp/B0BWWVQZTG/ref=sr_1_16)

Time: (optional)


The DS3231 A real time clock (RTC) is great to have to


put the microprocessor to sleep and not use up the power (unless you manage to wire the power) when not in use / when not transmitting the data. There are other versions that are also available. This model has a rechargeable battery vs. a coin cell battery that will eventually need to be replaced.

https://www.amazon.com/Dorhea-DS3231-Module-Memory-


Raspberry/dp/B08X4H3NBR/ref=sr_1_3? (https://www.amazon.com/Dorhea-DS3231-Module-Memory-Raspberry/dp/B08X4H3NBR/ref=sr_1_3)

Processor/Transmitter

ESP32 (Processor AND transmitter}

Build-Up Options:

Your weather station can be built with a wide variety of options which will be explored. These options may be individual or combined depending on your needs.

Here are possible configurations:

Basic:
Internal sensors require minimal fabrication.
- Temperature, Humidity
- DHT-11, DHT22 Sensors.
- AHT10 Sensor.
- Temperature, Humidity, Pressure.
- BME280.
- Temperature, Humidity, Pressure, VOC’s (Volatile Organic Compounds - Air Quality)
- BME680.

Intermediate:
Sensors requiring some physical material fabrication, holes, mounting materials.
- (Basic Components - as listed above).
- Anemometer - DC Generator, resistors and a mounting bracket, hole for wiring.
- UV Sensor
- Adafruit LTR-390 - requires a hole and weather protective window.

Advanced:
Sensors that require moderate to extensive mechanical fabrication and adaptation, external holes.
- Wind Direction Sensor - rotary magnetic, optical, or mechanical switch sensing with an air vane to detect air flow direction.
- AS5600 - rotary magnetic position sensor.
- A3144 Hall Effect sensor or A3144 Hall Effect sensor module board, magnet(s).
- TCRT5000 Reflectance sensor(s), position disk.
- Participation Sensor (Rain Gauge)
- A3144 Hall Sensor, 3D printed tipping bucket assembly.
- LM393 Rain Drop Sensor Monitor.
- Capacitive Analog Soil Sensor Module.
- Rain gauge sensor with ultrasonic or TOF (Time of Flight) distance sensor.

The above options may be selected or combined to create your weather station. We will explore some of these options with design examples to help you get started.

First Steps:

- What is the intended application of your weather station?
- Classroom project, school project?
- Do you have an intended time frame for installation and use?
- Can you get permission and a designated place to install the weather station?
- Consider the location of your weather station.
- Is it to be inside or outside - Are measuring indoor air quality, lighting, etc.
- Does the location have readily available power?
- Does the location have readily available Wi-Fi?
- Is the location easily accessible?
- Is the location secure?
- What kind of data do you wish to collect?
- Some sensors are easy to use and require very little maintenance others may require occasional repair or adjustment.
- Are you considering microclimate measurement with multiple stations or having a relocatable station?
- How will you share the data with your students, school, community?
- Do you expect that your station and data will be used to help plan or make decisions based on the data you collect? For example, a community garden, air quality monitoring?
Based on the questions above hopefully you can formulate the intent and purpose of the weather station as well as what kind of data you wish to acquire/use.

Project Planning:

Consider the scope of your project and the resources that you will be able to apply. This project can be incremental, and scaled based on the resources that you have at hand. Consider a part of this project could be to build a case for expansion and permanence at your school, location. It may be useful to start small, demonstrate utility or interest and then expand.

Design Example - Basic - Web Based Reporting

In this example we want a weather station that can be located outside but next to a classroom window. We may find a better location later but for now we would like to have something that we can experiment with and easily observe. Power will be routed through the window using a 12V DC power adapter. Wi-Fi is available and reliable next to the window, and we have permission from our IT department to use the network. Our school is happy and interested in having the data posted on the CIJE Weather Station Hub site, so our IT department will allow outgoing internet traffic from our weather station.


Shown above is an image of a basic weather station using an ESP32 (ACEBOTT), (https://www.amazon.com/ACEBOTT-Development-Board-Compatible-Arduino/dp/B0D5D7Q42V) a half bread board and a BME280 sensor. This is a very simple example of a web posting weather station.

We have some wiring to do, coding (most of it is provided) and some testing.

Weather Station Specifications:

# | Sensing Parameter | Sensor | Notes

1 | Temperature | DHT22 - DPin - 3.3V-5V | Amazon - DHT22 (https://www.amazon.com/Teyleten-Robot-Digital-Temperature-Humidity/dp/B0CPHQC9SF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)E (https://www.amazon.com/SazkJere-GY-BME280-5-Atmospheric-Pressure-Temperature/dp/B0CMHGBPC7)280 not BM (https://www.amazon.com/SazkJere-GY-BME280-5-Atmospheric-Pressure-Temperature/dp/B0CMHGBPC7)P (https://www.amazon.com/SazkJere-GY-BME280-5-Atmospheric-Pressure-Temperature/dp/B0CMHGBPC7)280 (https://www.amazon.com/SazkJere-GY-BME280-5-Atmospheric-Pressure-Temperature/dp/B0CMHGBPC7)
| Humidity | DHT22 - DPin - 3.3V-5V
# | Hardware | Type

2 | ESP32 | ESP32 Board | ACEBOTT UNO format ESP32 (https://www.amazon.com/ACEBOTT-Development-Board-Compatible-Arduino/dp/B0D5D7Q42V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)
3 | Breadboard | Mini Breadboard | Makes for easy design changes (https://www.amazon.com/Breadborad-Solderless-Breadboards-Distribution-Connecting/dp/B082VYXDF1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)
4 | 1N5817 Diode (2) | Overvoltage Protection | 1N5817 Schottky Diode (https://www.amazon.com/dp/B07Q5H1SLY?ref_=ppx_hzsearch_conn_dt_b_fed_asin_title_1)
5 | 10KΩ 1/4W Resistor | Anemometer V/Divider | 10K resistor
6 | 1KΩ 1/4W Resistor | Anemometer V/Divider | 1K resistor (https://www.amazon.com/10K-Resistor-Tolerance-Resistors-Resistance/dp/B0B4JFPHTW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)

7 | 100KΩ 1/4W Resistor | Battery V/Divider | 100K resistor (https://www.amazon.com/10K-Resistor-Tolerance-Resistors-Resistance/dp/B0B4JDHXC9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)
8 | 15KΩ 1/4W Resistor | Battery V/Divider | 15K resistor (https://www.amazon.com/10K-Resistor-Tolerance-Resistors-Resistance/dp/B0B4JCGX1Z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)
9 | 12VDC Adapter | 12V 1A 5.5mm x 2.1mm | Power for Station (https://www.amazon.com/Adapter-Speakers-Appliances-Surveillance-Switching/dp/B0CQXK1FSM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)
10 | Plastic Container | 48 oz, 7” x 10” x 2” | Station Enclosure (https://www.amazon.com/dp/B0CPP3KDQQ?ref_=ppx_hzsearch_conn_dt_b_fed_asin_title_1&th=1) - Zip-tied to block
11 | Snap-in Support | PCB Mounting Post | Amazon PCB Support (https://www.amazon.com/dp/B09WZWY9L3?aref=OMxKOacSRU)
12 | Dupont Jumpers | Female to Male (10) | Component interconnects (https://www.amazon.com/EDGELEC-Breadboard-Optional-Assorted-Multicolored/dp/B07GD2BWPY)
13 | Hot Glue | | To secure items if required

Network

SSID | URSchool
Password | 123456
IT Contact | Phone Number | email
Jim Dandy | 555-2134 | jd@ITOffice.biz

Note:
Resources listed are suggested components and vendors, you may use whatever source you see fit. It is recommended that component substitutes be selected based on similar specifications. Please consult your CIJE High School Mentor if in doubt prior to purchasing.


Weather Station Wiring for Anemometer, BME280 Sensor and Measuring Battery Voltage


Food Tray Container 1
AceBott ESp32 | 1
Half Breadboard | 1
BME280 | 1
1N5817 Diode | 2
Snap-in Support | 3-4


After gathering the above components, place them in the bottom of the Food Tray Container. Do a visual check first by placing them centered both vertically and horizontally next to each other. The easiest way to secure them is to use the adhesive Snap-in Support and the using the adhesive backing on the half breadboard. Mark or try positioning the ESP32 board and the half breadboard first and mark or identify where they go.

Steps:
- Insert the supports into the AceBott ESP32 board.
- Remove the adhesive, use the previous positioning and place it in the bottom, note it is suggested that once in place you apply hot glue to the adhesive pads to add another layer of attachment to the food tray.
- Remove the adhesive backing on the half breadboard and firmly place it next to the ESP32.
- You may insert the BME280 into the breadboard where you think it will work best.
- The BME280 pins VCC, GND, SDA, SCL should be accessible via other pins on the breadboard.
- You will connect pins via Dupont jumpers to the ESP32.

Now that you have mounted the components, make a couple of notes.

- The location of the programming port.
- The location of the power port.

Using the above information consider how you want to connect those ports to the outside. The programming port will only be used initially to program the weather station and may only be required for changes. Power will be required to operate the weather station and should be both secure (not easily removed) and weatherproof.
We have designed a weather seal that you can 3D print if you like. We have a cutout template as well. A small USB C port plug is also included. You will find the 3D
STL file and the cutout template in the weather station
resource drive.

After using the cutout and inserting the weather seal you may want to use Silicone RTV to attach the seal. RTV is a good adhesive to use, it is weatherproof, remains pliable and is easy to remove.
You can use the container lid as the base to mount and seal the
project. The weather station in its current configuration can be mounted in any orientation. However, if you plan on adding additional sensors it is recommended that the lid be mounted on the bottom and horizontal to the ground. You can secure the lid by any method that you prefer. We mounted the bottom using 4 holes and tie wraps.


The bottom lid should have one or two small holes to allow for pressure equalization and moisture to exit. 1/16” holes are recommended. Larger holes may encourage insects to build nests in the enclosure and cause problems with the electronics.

Wiring:

Wiring the weather station will require minimal preparation.
- Acquire 4 Female to Male Dupont Jumpers.
- Using the following chart connect jumpers as shown in the wiring chart.


| Description | ESP32 | ESP32 Pin | Sensor | Sensor Pin
1 | DHT22 Environmental Sensor | 5V | H1 5V | 5V | VCC
| | GND | H1 GND | GND | GND
| | S | H1 5 | D | D
2 | 100KΩ 1/4W Resistor | Receive the Battery voltage from the voltage divider network. Use pin 33 for the analog input. | | Form a voltage divider network, with one end of 100KΩ going to the battery supply, and the other to the junction of the 15KΩ. The other end of the 15KΩ should go to GND.
3 | 15KΩ 1/4W Resistor
4 | 1N5817 Diode (2) | Overvoltage Protection | 1N5817 Schottky Diode (https://www.amazon.com/dp/B07Q5H1SLY?ref_=ppx_hzsearch_conn_dt_b_fed_asin_title_1) | | 1N5817 Diode (2)

Upon completion have someone else double check the connections. Note:

Resources listed are suggested components and vendors, you may use whatever source you see fit. It is recommended that component substitutes be selected based on similar specifications. Please consult your CIJE High School Mentor if in doubt prior to purchasing.

Software:

This may be the most challenging part of this project. If you have never used an ESP32 before there are a few steps that we have to take before we can use the ESP32 with the Arduino IDE.

Assuming you have used the Arduino IDE before we will need to open the application and set some parameters:

Open the Arduino IDE and using the File Tab, scroll down to the dialog box called “Preferences.”

Notice in the dialog box
the section a section that
says:
Additional Boards
manager URLs.

Click on the green window
selector on the right.

Here we will enter the URL that will point to
descriptions of the
Esprissif.

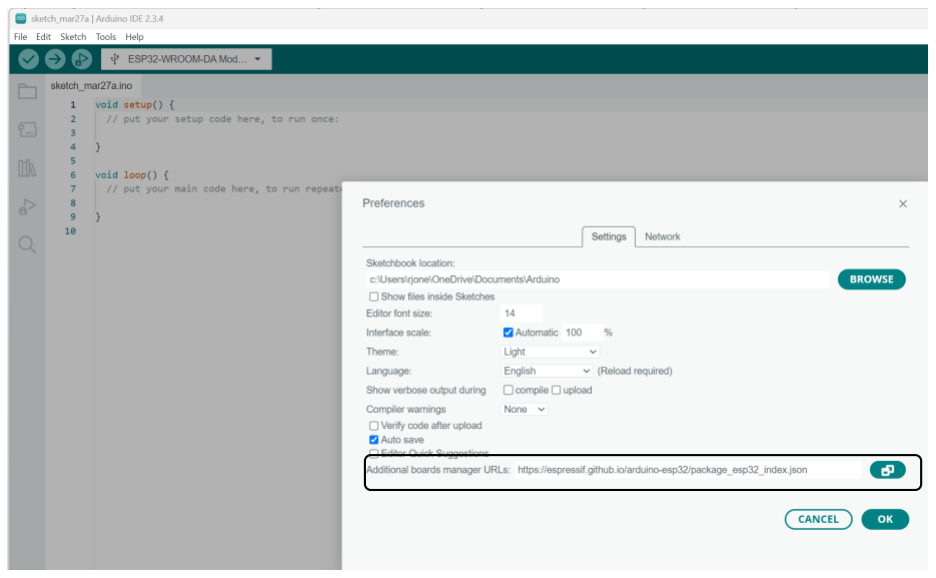
[picture p60: figure]

https://espressif.github.io/arduino-esp32/package_esp32_index.json


Cut and paste the above URL into the URL dialog box. When complete “Click OK”.

This will begin a process that will request the Arduino IDE to go out on the Internet to download the various board descriptions.

Note:

- You must have internet access to download these files.
- Depending on your Internet access it may take
up to a half hour or more to complete.
- You cannot proceed until this is accomplished.

Select the Board Manager to configure the IDE for ESP32 boards. On the Left Dialog tab, find and open the item marked as Board Manager (as shown on the right).

In the Boards Manager Search Box type “ESP32”. Typically, two suggestions will pop up.

- Arduino ESP32 Boards by Arduino
- esp32 by Espressif Systems

Install esp32 by Espressif Systems.
Installations will take a while so be patient.


Upon completion of the Board Manager move to the “Tools” tab and scroll down to Board and allow the dialog box to open on the right. Select esp32 and allow that dialog box to open. You will see possibly 50 different boards and selecting the “right one” is critical to get your code to compile.

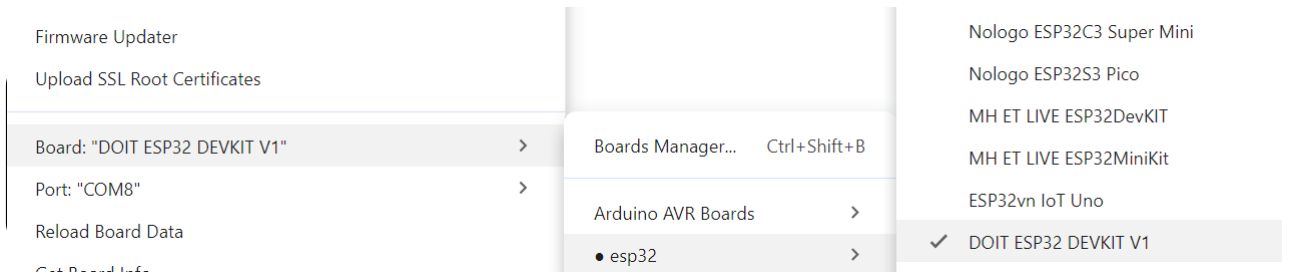
[picture p61: figure]

Scroll through the esp32 board tab and look for:
- DOIT ESP32 DEVKIT V1

This module will populate the various parameters of the board into the IDE. If you plug in the ACEBOTT board now you will have to select
the com port for programming.


Select from the Tools Com Drop Down Box.

Note:
Resources listed are suggested components and vendors, you may use whatever source you see fit. It is
recommended that component substitutes be selected based on similar specifications. Please consult your CIJE High School Mentor if in doubt prior to purchasing.

The com port that the board is attached to.

In the example to the right
“COM8 Serial Port (USB)”
yours will probably be different.

Click “OK” when complete.

If you do not see an available COM port, please contact your instructor or IT specialist to identify the port location or Serial to USB driver for your PC (this process is different for PC’s, Mac’s and Chromebooks).

After completing these steps, we can begin configuring the IDE for the code, and sensors of your weather station.

For the basic weather station using the BME280 and the ACEBOTT ESP32 go to the following URL and download the following Arduino Program Code:

Code Operation:

Lines 25-28 are code inclusion statements for the various libraries need to:

- Enable Wi-Fi operation.
- Enable Web Server communication.
- Provide driver interface for DHT Temperature and
Humidity sensor.

Lines 62-76 setup variables to use with:
- CIJE Weather Station ID # and Passkey, obtained by registering your station on the CIJE Weather Station Site
- Require Network credentials, SSID and Password
- ULR location of the CIJE Weather station Server for data posting


Lines 30-60 contain variable assignments and default variable values:
- DHT22 sensor instance assignment and pin number
- Variables for
- Wind Speed
- Battery Voltage Sensor pin
- Battery Voltage A/D count
- Battery Voltage Analog value
- Wi-Fi Connection Wait Timeout value

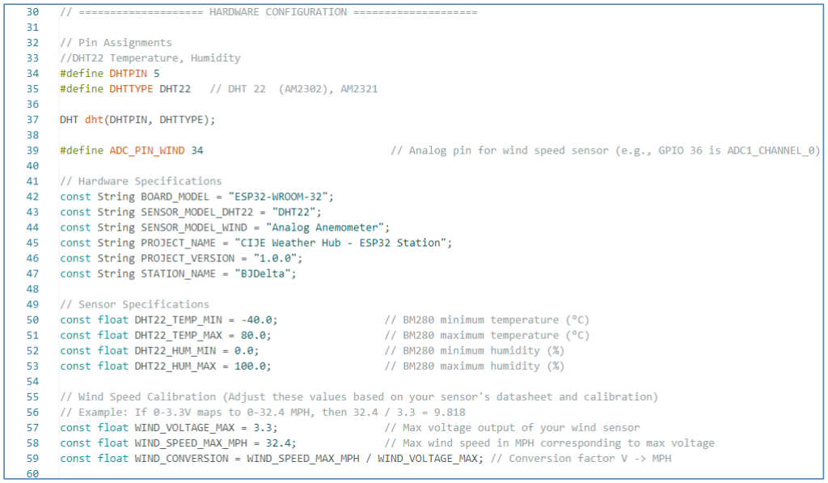
[picture p62: figure]

Lines 104-141 provide initialization instructions in void setup()
- Serial Monitor (115200 Baud)
- DHT22 Initialization
- Find and verify DHT22 Sensor operation.
- Connect to Wi-Fi and verify operation.
- Post Weather Data to CIJE Weather Station Web Portal.

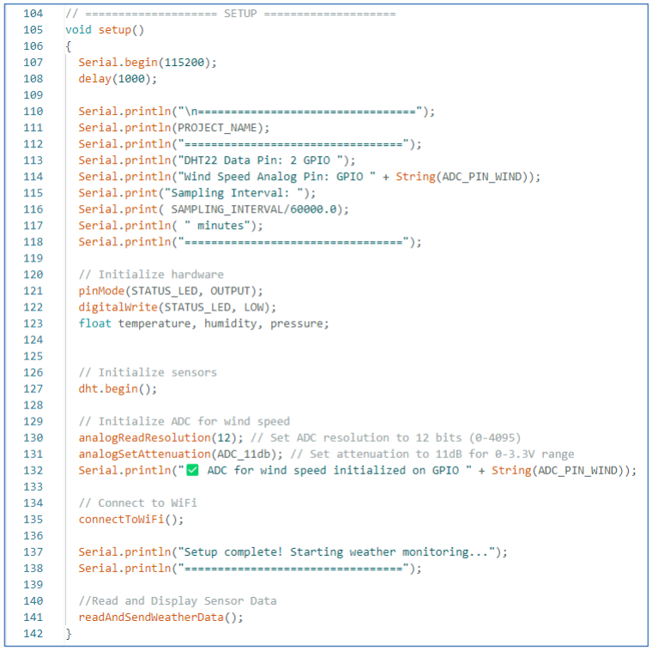
[picture p63: figure]

Lines 144-183 indicate null operation of the void loop().
- The primary function of the void loop() is to determine the post interval.
- Verify that the Wi-Fi connection is still active.
- LED Blink status light reporting.

Function Descriptions:

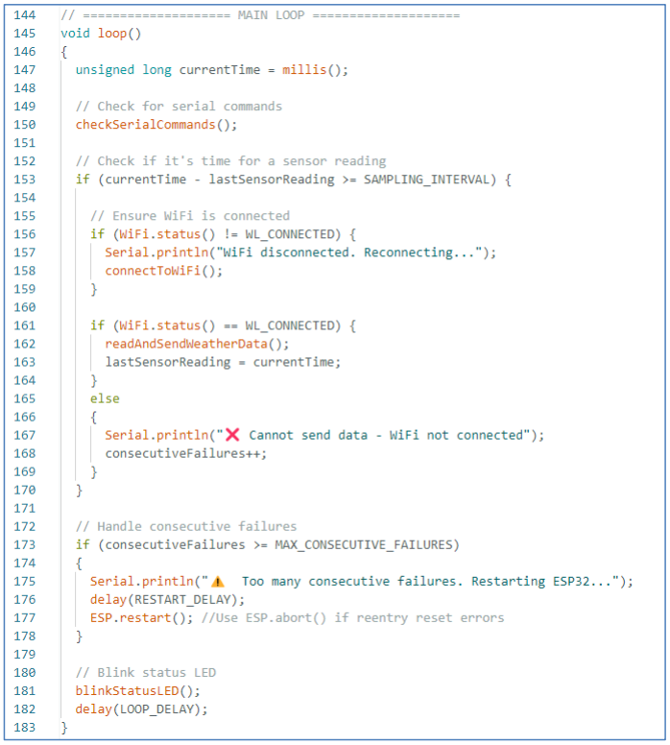
[picture p64: figure]

Lines 99-118 Provide the necessary code for connecting and authenticating with your Wi-Fi network.
- Using your SSID and Password begin the Wi-Fi connection process.
- Determine if the Wi-Fi connection has been established within the assigned time.
- Print the status of the attempted Wi-Fi communication.
- Upon exit of the function return a “True” or “False” status of the attempt

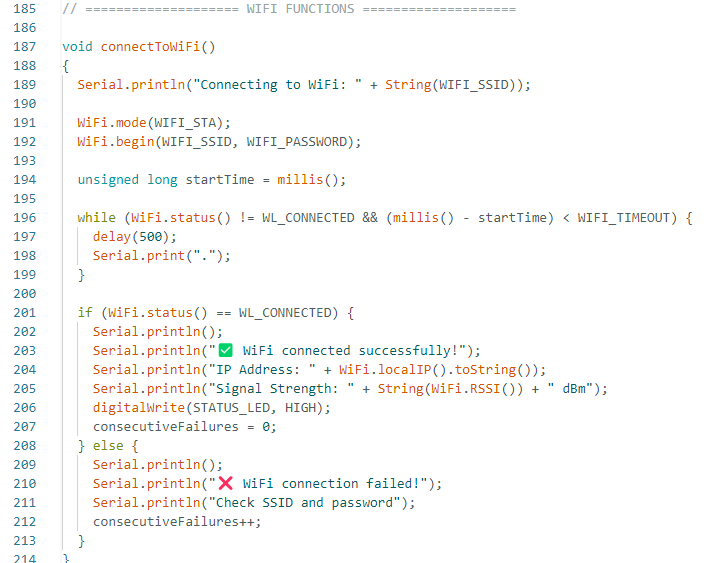
[picture p65: figure]

Lines 216-227 is used to read the analog output of the wind generator and calculate the wind speed.
Note: This calculation may need to be adjusted for accurate readings.

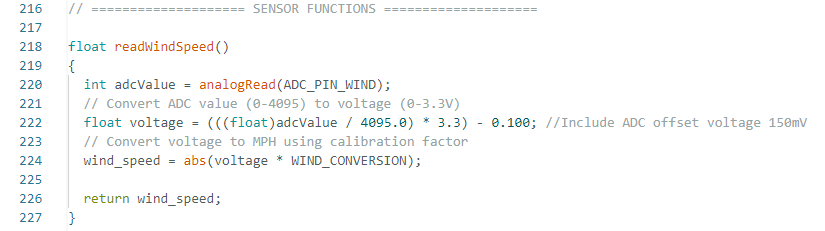
[picture p66: figure]

Lines 229-268 Contains a set of instructions to read the weather sensors and to format the data for sending (posting).
- Verify DHT22 sensor working.
- Convert the DHT22 sensor data into a readable form.
- Notify the Blink status LED of sensor read.

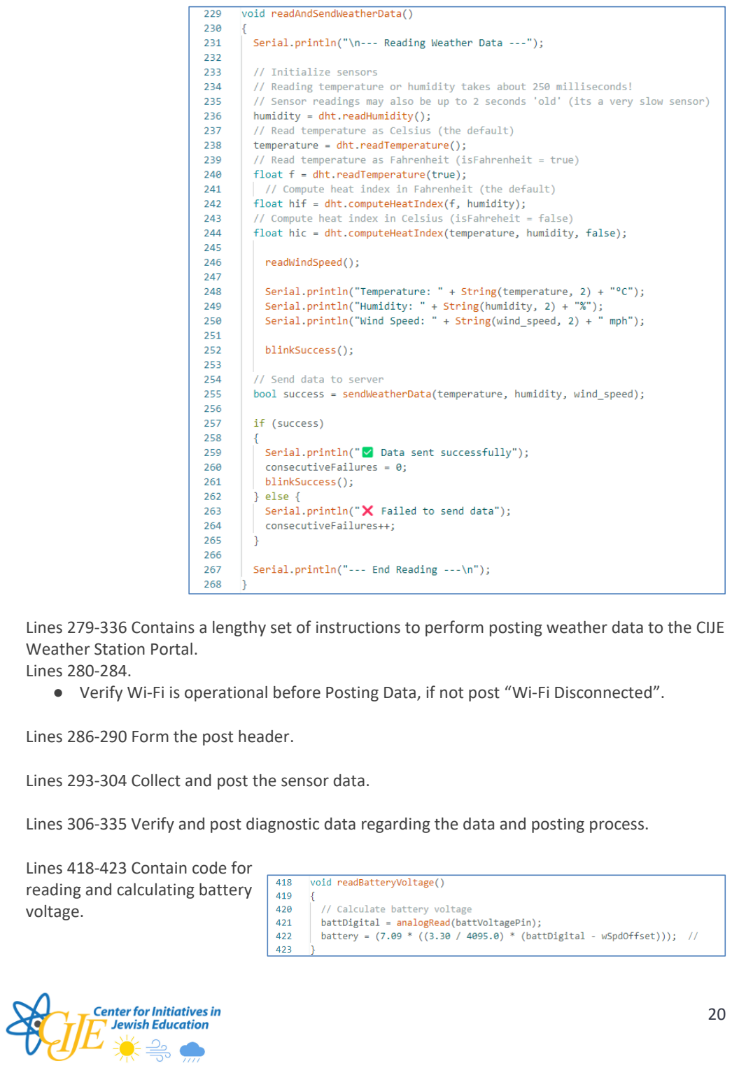
[picture p67: page 20]

Lines 279-336 Contains a lengthy set of instructions to perform posting weather data to the CIJE Weather Station Portal.
Lines 280-284.
- Verify Wi-Fi is operational before Posting Data, if not post “Wi-Fi Disconnected”.

Lines 286-290 Form the post header.

Lines 293-304 Collect and post the sensor data.

Lines 306-335 Verify and post diagnostic data regarding the data and posting process.

Lines 418-423 Contain code for
reading and calculating battery
voltage.

The previous code description outlines a basic Weather Station. Additional sensors and operations can be added to advance the capability of the Weather Station for Intermediate, and Advanced Operation.
