CIJE-STEM/cije-weather-station/docs/ESP32setup.pdf

# Using the ESP32 and REST APIs

## Making sense of IOTs (Internet of Things)

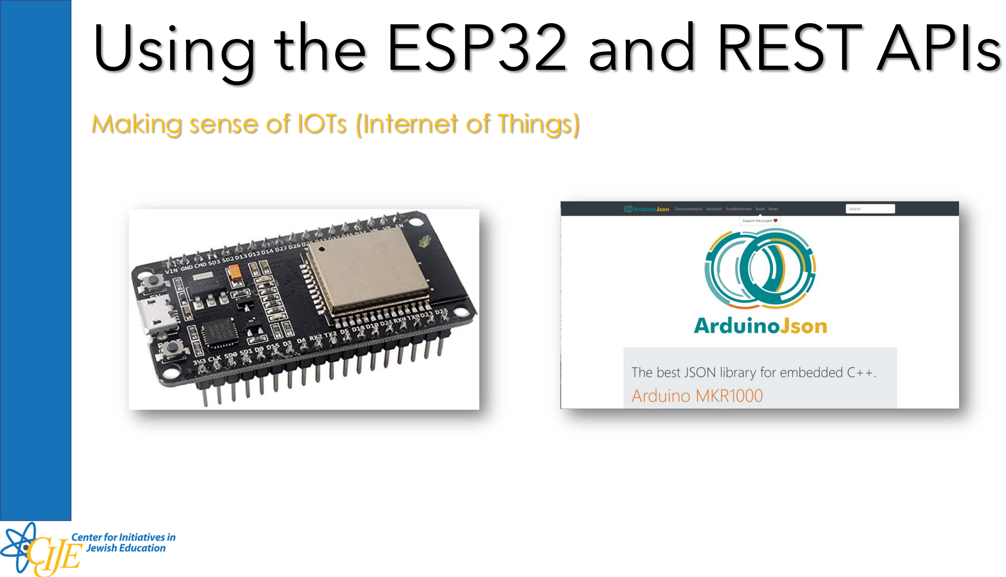
[picture p68: page 1]

# Quick Links

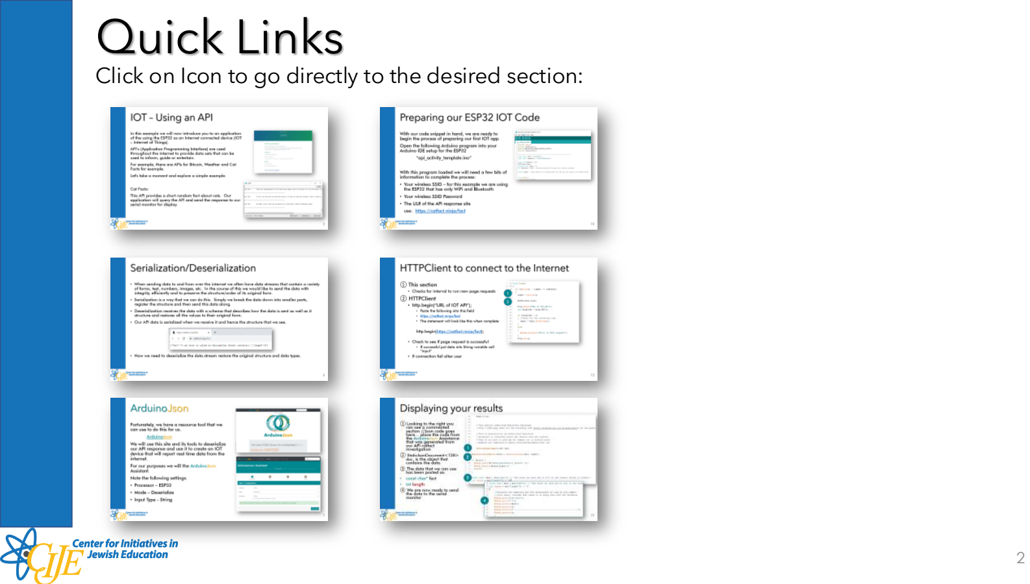
[picture p69: page 2]

Click on Icon to go directly to the desired section:

# IOT – Using an API

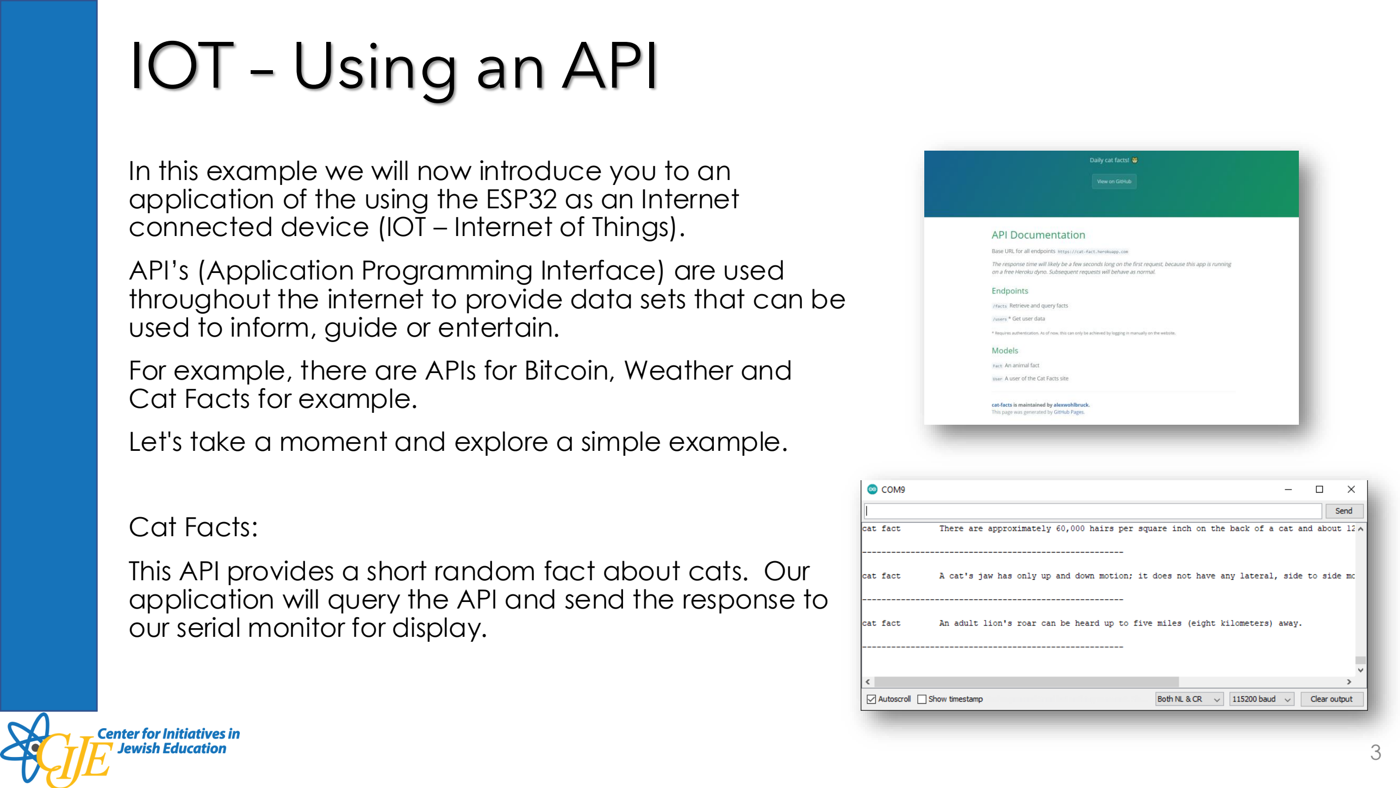
[picture p70: page 3]

In this example we will now introduce you to an application of the using the ESP32 as an Internet connected device (IOT – Internet of Things).
API’s (Application Programming Interface) are used throughout the internet to provide data sets that can be used to inform, guide or entertain.
For example, there are APIs for Bitcoin, Weather and Cat Facts for example.
Let's take a moment and explore a simple example.

Cat Facts:
This API provides a short random fact about cats. Our application will query the API and send the response to our serial monitor for display.

# What do we need?

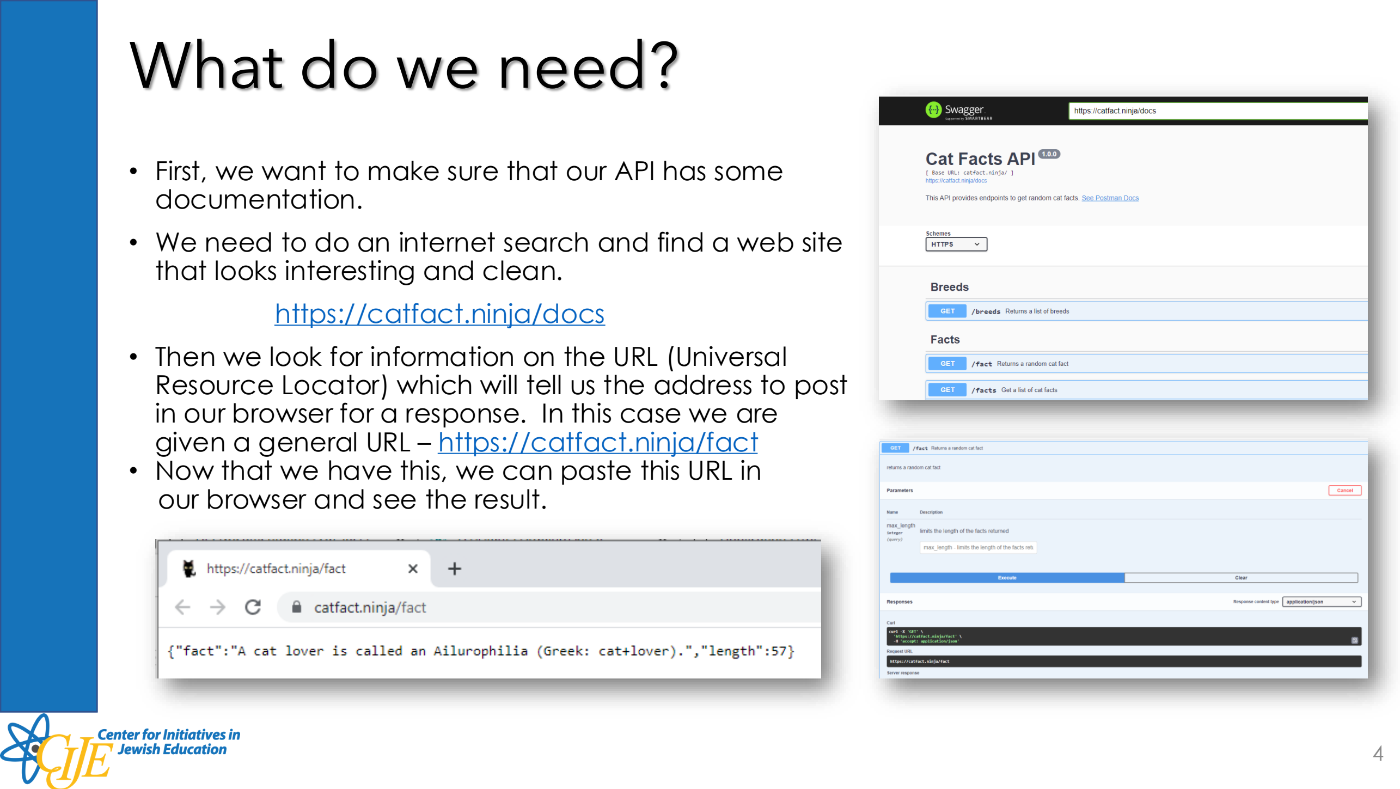
[picture p71: page 4]

- First, we want to make sure that our API has some documentation.
- We need to do an internet search and find a web site that looks interesting and clean. https://catfact.ninja/docs
- Then we look for information on the URL (Universal Resource Locator) which will tell us the address to post in our browser for a response. In this case we are given a general URL – https://catfact.ninja/fact
- Now that we have this, we can paste this URL in
our browser and see the result.

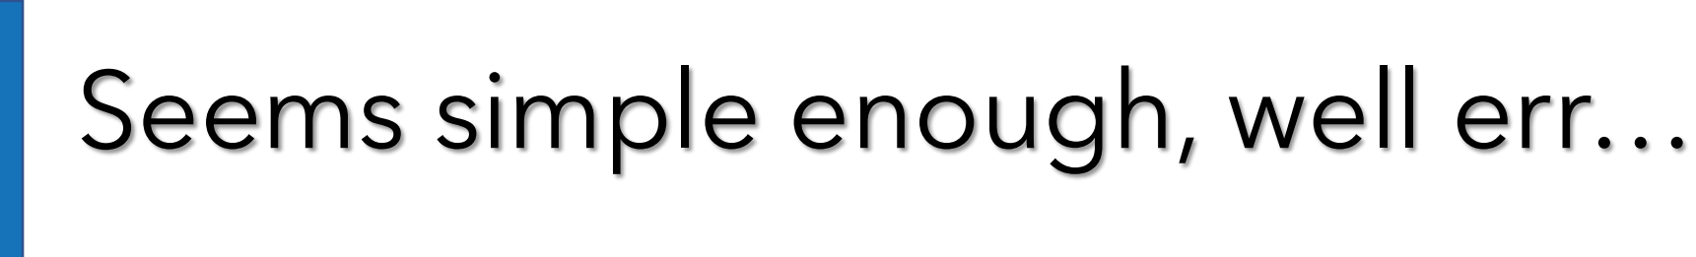
[picture p72: figure]
Seems simple enough, well err…

- Well, this seems simple enough but if we look further, we can see that there is a form to the response.

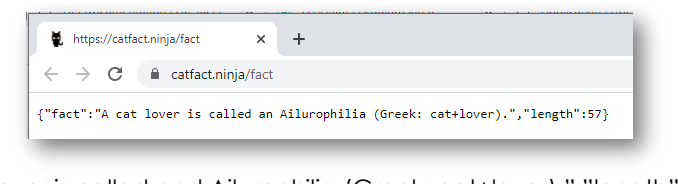
[picture p73: figure]

- {“fact”:”A cat lover is called and Ailurophilia (Greek: cat+lover).”,”length”:57}, so notice we have a field name, :” fact”, and “length” followed : by text and : a number. Given this simple example we might be able to convert this to a string – fact$, and length as an integer. However, this means that in every example API response we will need see the return format and to formulate how to decode the information.
- We do an easier way to approach this. JSON – JavaScript Object Notation. In fact, due to this problem as well as many other similar instances where we want to send data over the internet there are tools sets designed to capture this data and convert into an easier form of char, int, float, etc. types that we can use in our C++ program.

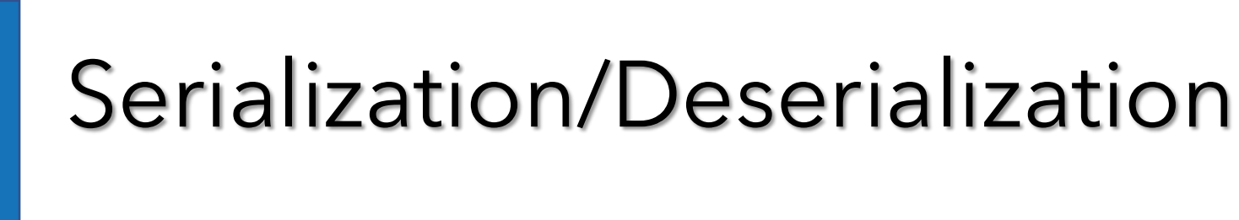
[picture p74: figure]
Serialization/Deserialization

- When sending data to and from over the internet we often have data streams that contain a variety of forms, test, numbers, images, etc. In the course of this we would like to send the data with integrity, efficiently and to preserve the structure/order of its original form.
- Serialization is a way that we can do this. Simply we break the data down into smaller parts, register the structure and then send this data along.
- Deserialization receives the data with a schema that describes how the data is sent as well as it structure and restores all the values to their original form.
- Our API data is serialized when we receive it and hence the structure that we see.

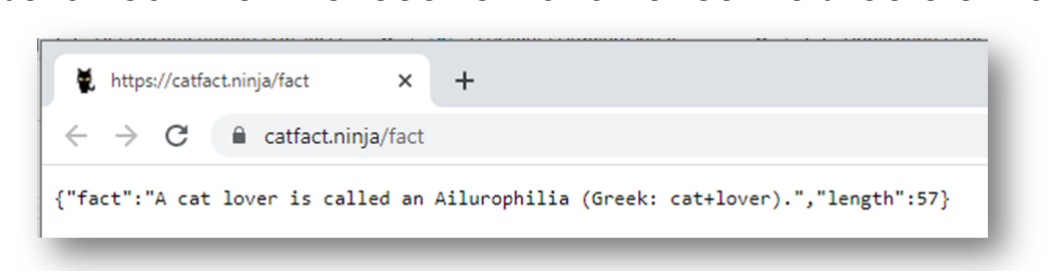
[picture p75: figure]

- Now we need to deserialize the data stream restore the original structure and data types.

# ArduinoJson

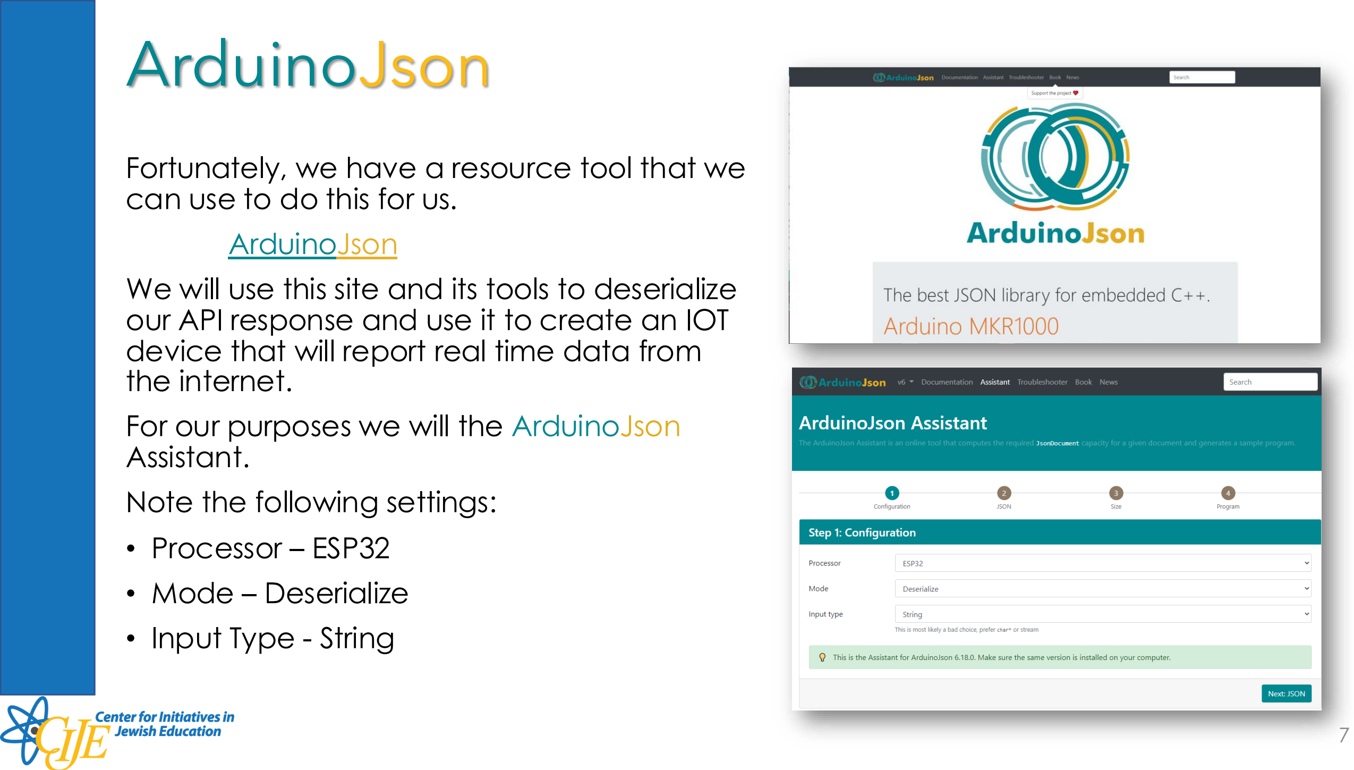
[picture p76: page 7]

Fortunately, we have a resource tool that we can use to do this for us.
ArduinoJson (https://arduinojson.org/)
We will use this site and its tools to deserialize our API response and use it to create an IOT device that will report real time data from the internet.
For our purposes we will the ArduinoJson Assistant.
Note the following settings: • Processor – ESP32 • Mode – Deserialize • Input Type - String

# ArduinoJson

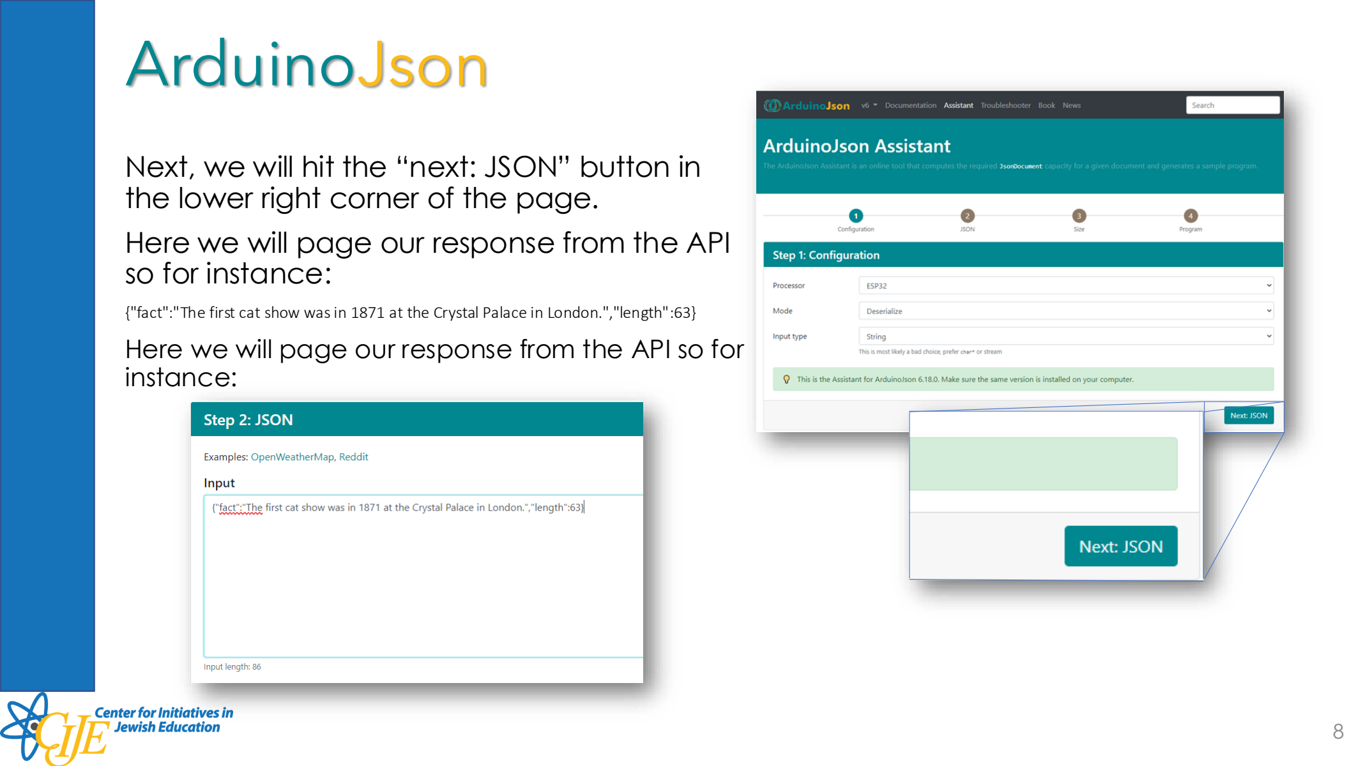
[picture p77: page 8]

Next, we will hit the “next: JSON” button in the lower right corner of the page.
Here we will page our response from the API so for instance:

{"fact":"The first cat show was in 1871 at the Crystal Palace in London.","length":63}
Here we will page our response from the API so for instance:

# ArduinoJson

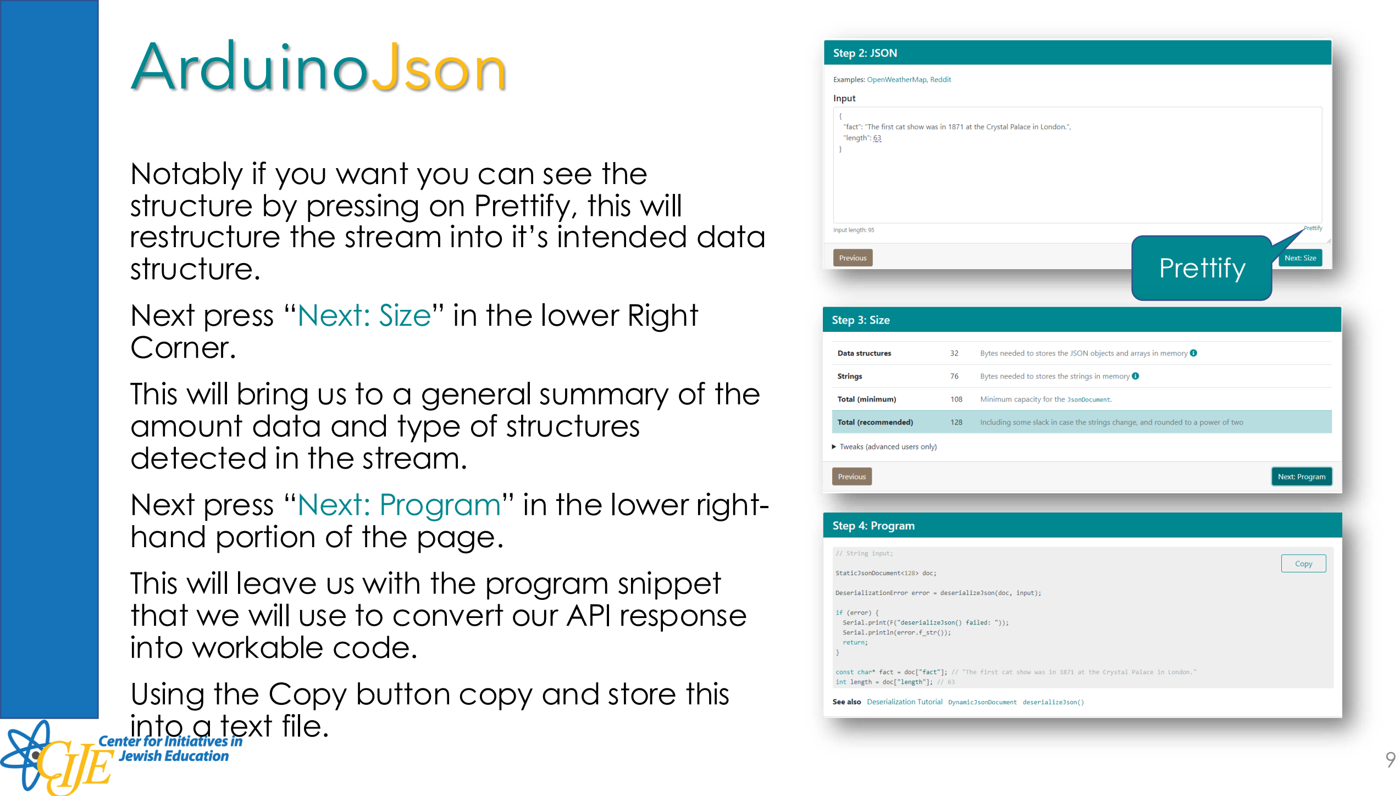
[picture p78: page 9]

Notably if you want you can see the structure by pressing on Prettify, this will restructure the stream into it’s intended data structure.
Next press “Next: Size” in the lower Right Corner.
This will bring us to a general summary of the amount data and type of structures detected in the stream.
Next press “Next: Program” in the lower right -
hand portion of the page.
This will leave us with the program snippet that we will use to convert our API response into workable code.
Using the Copy button copy and store this into a text file.

Prettify

# Preparing our ESP32 IOT Code

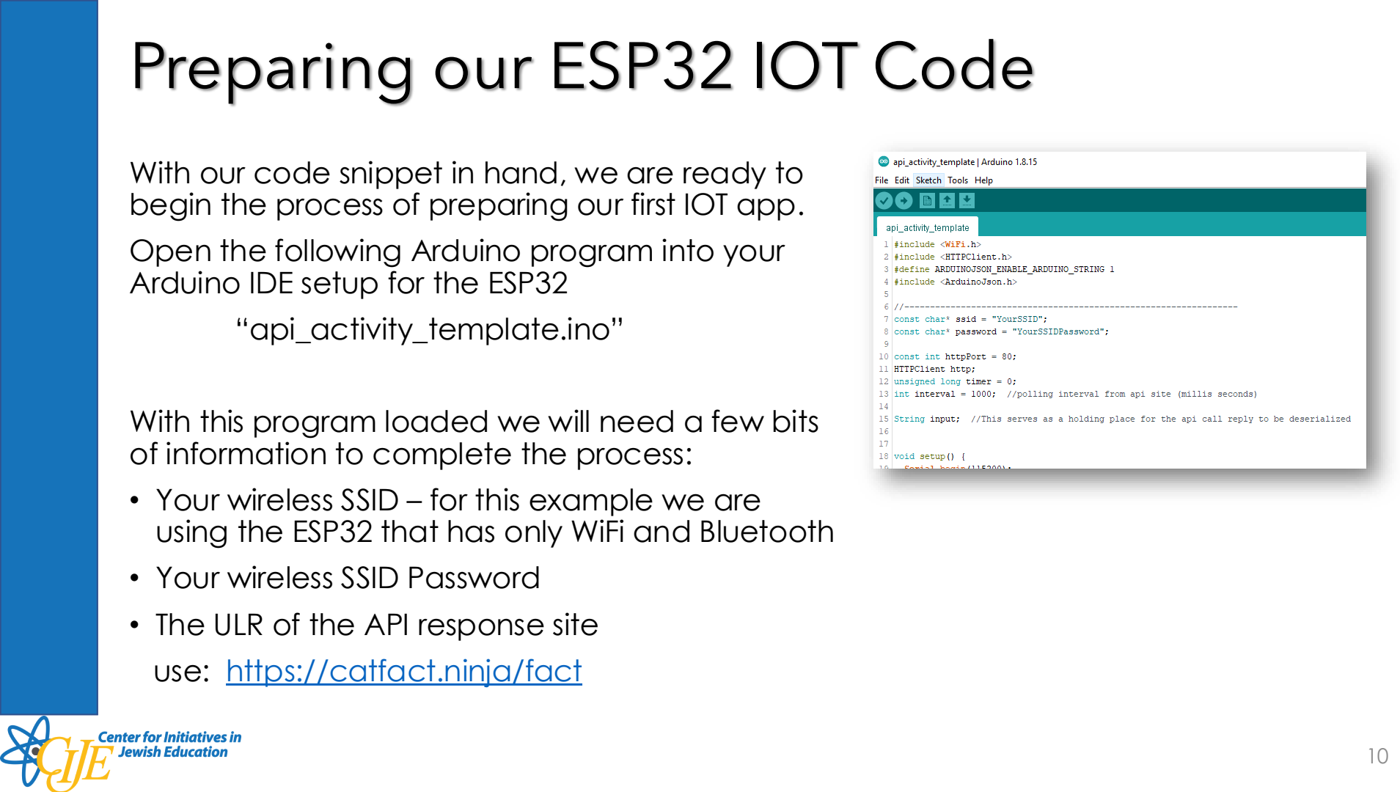
[picture p79: page 10]

With our code snippet in hand, we are ready to begin the process of preparing our first IOT app. Open the following Arduino program into your Arduino IDE setup for the ESP32 “api_activity_template.ino”

With this program loaded we will need a few bits of information to complete the process:
- Your wireless SSID – for this example we are using the ESP32 that has only WiFi and Bluetooth
- Your wireless SSID Password
- The ULR of the API response site
use: https://catfact.ninja/fact

# Setting up your Wireless Network

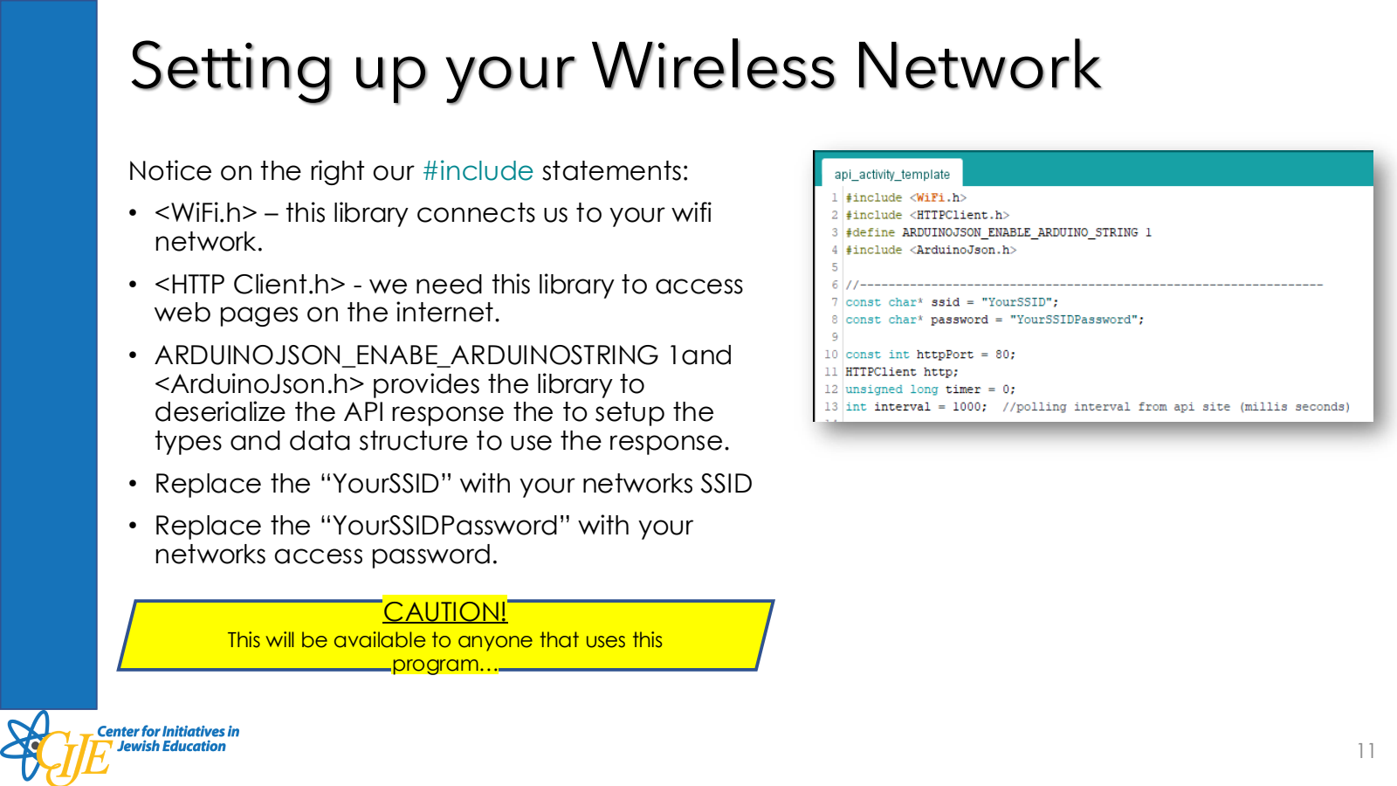
[picture p80: page 11]

Notice on the right our #include statements:
- <WiFi.h> – this library connects us to your wifi network.
- <HTTP Client.h> - we need this library to access web pages on the internet.
- ARDUINOJSON_ENABE_ARDUINOSTRING 1and <ArduinoJson.h> provides the library to deserialize the API response the to setup the types and data structure to use the response.
- Replace the “YourSSID” with your networks SSID
- Replace the “YourSSIDPassword” with your networks access password.

CAUTION!
This will be available to anyone that uses this program…

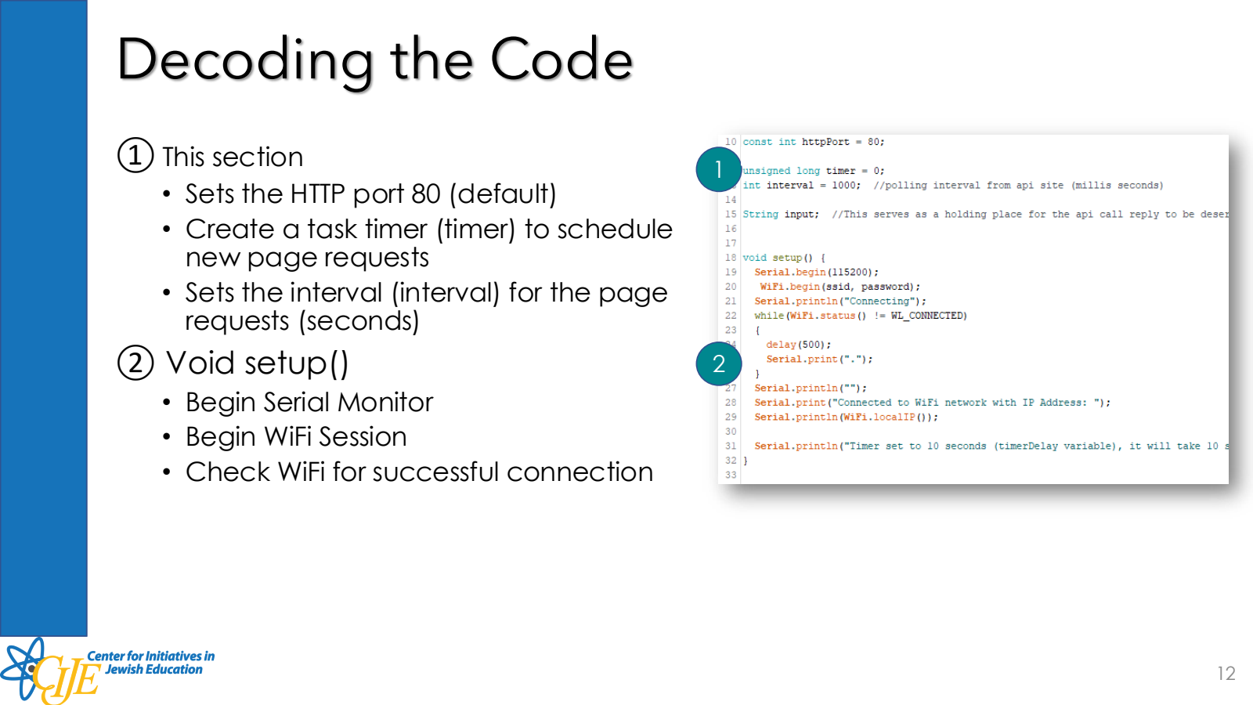
[picture p81: page 12]

Decoding the Code ①This section • Sets the HTTP port 80 (default) • Create a task timer (timer) to schedule

new page requests
- Sets the interval (interval) for the page requests (seconds)
② Void setup() • Begin Serial Monitor • Begin WiFi Session • Check WiFi for successful connection

12

# HTTPClient to connect to the Internet

## ① This section

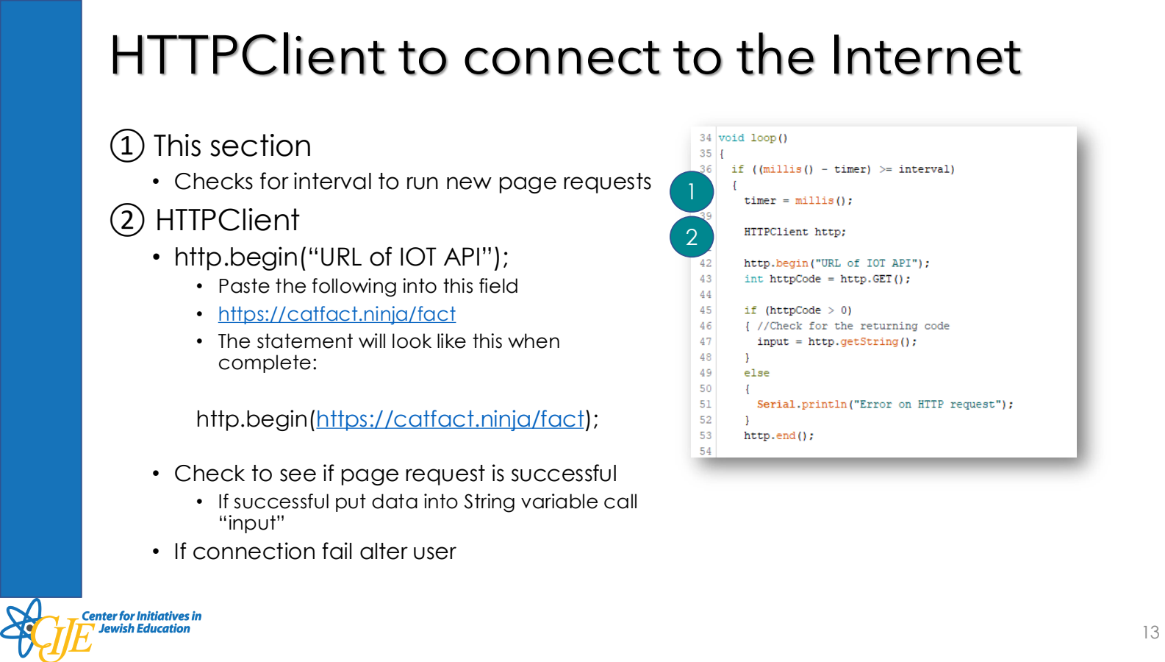
[picture p82: page 13]

- Checks for interval to run new page requests

## ② HTTPClient

- http.begin(“URL of IOT API”);
- Paste the following into this field
- https://catfact.ninja/fact
- The statement will look like this when complete:

http.begin(https://catfact.ninja/fact);

- Check to see if page request is successful
- If successful put data into String variable call “input”
- If connection fail alter user

1

2

# Deserialization

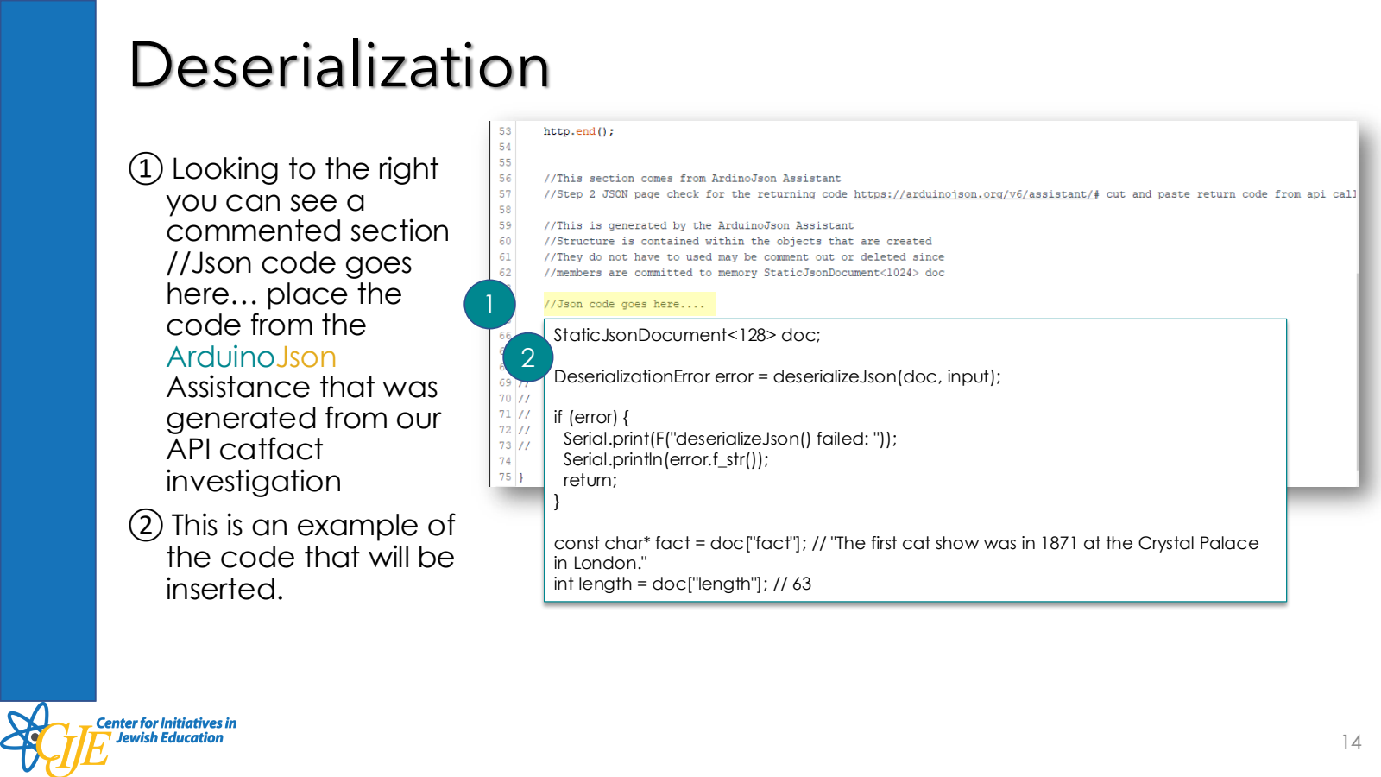
[picture p83: page 14]

①Looking to the right
you can see a
commented section
//Json code goes
here… place the
code from the
ArduinoJson
Assistance that was
generated from our
API catfact
investigation
②This is an example of
the code that will be
inserted.

1

StaticJsonDocument<128> doc;

DeserializationError error = deserializeJson(doc, input);

if (error) {
Serial.print(F("deserializeJson() failed: ")); Serial.println(error.f_str());
return;
}

const char* fact = doc["fact"]; // "The first cat show was in 1871 at the Crystal Palace in London."
int length = doc["length"]; // 63

2

# Displaying your results ①Looking to the right you

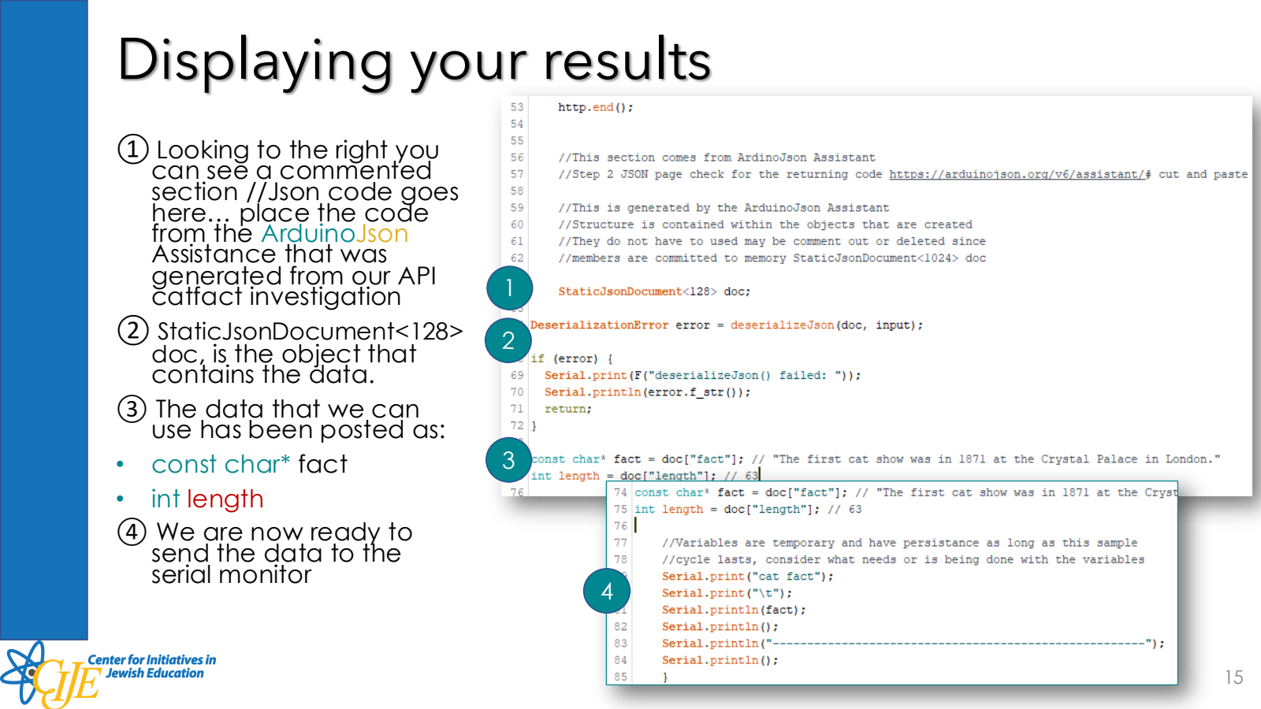
[picture p84: page 15]

can see a commented
section //Json code goes
here… place the code
from the ArduinoJson
Assistance that was
generated from our API
catfact investigation
② StaticJsonDocument<128>
doc

, is the object that
contains the data.
③ The data that we can
use has been posted as:
- const char* fact • int length ④ We are now ready to

send the data to the
serial monitor

13

4

# Enjoy Using the ESP32 and APIs

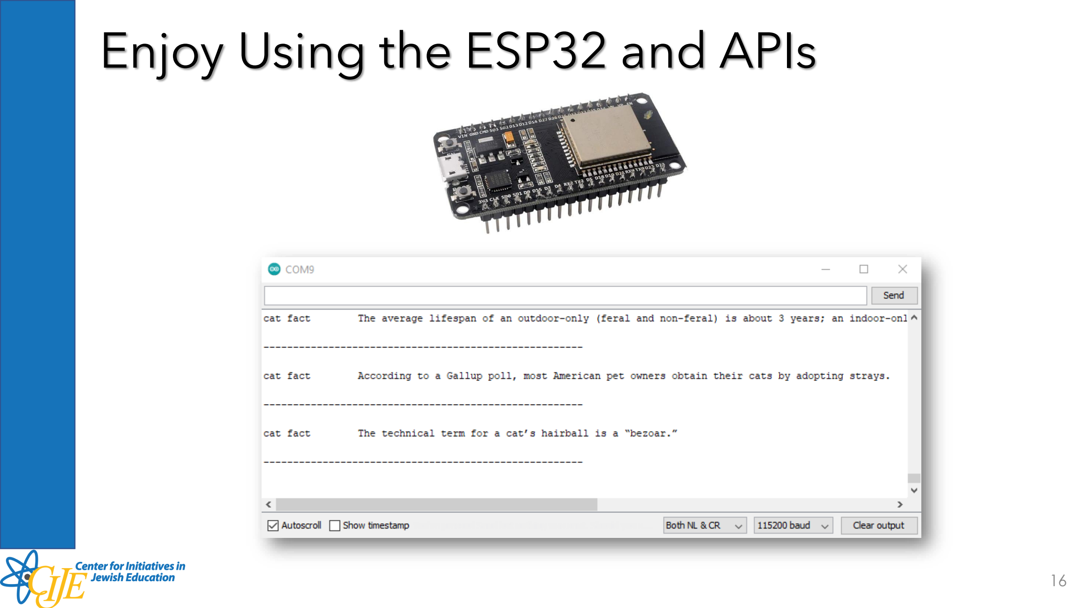
[picture p85: page 16]
