CIJE-STEM/cije-weather-station/docs/weather_station_cije_anemometer.pdf

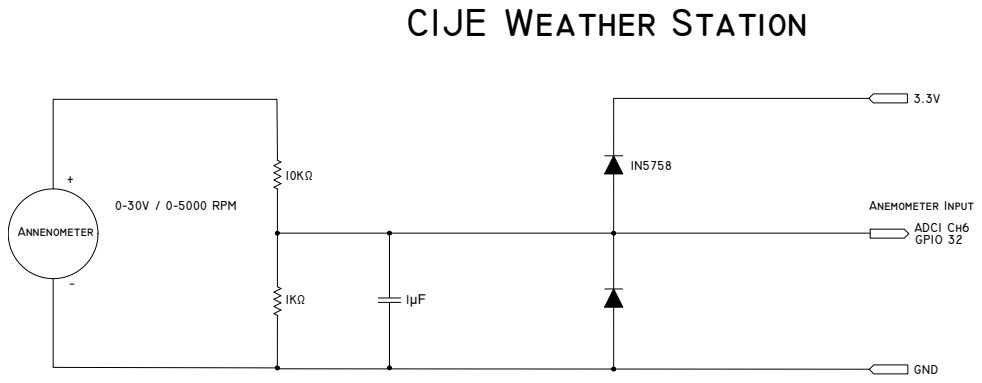
[picture p86: page 1]
+- Annenometer; 3.3V GND 10KΩ 1KΩ; 1N5758 0-30V / 0-5000 RPM; CIJE Weather Station; ADC1 Ch6 GPIO 32 Anemometer Input
