CIJE-STEM/cije-weather-station/(commit log)

2025-07-30 Create ESP32 setup.pdf
2025-09-29 Code for proper units
    Code changes performed for proper unit of temperature (Fahrenheit)
